facethesouth/require/docs/pcb.md

# Overall

* 6-layer PCB
* mechanical via only. no microvia or buried/blind vias.
* minimal trace width 0.1mm (4 mil)
* minimal via size 0.4mm/0.2mm (16mil/8mil)
* minimal soldermask width 0.1mm (4 mil)

# Footprint

The following footprint are created by the project. They should be carefully checked.

# Stack-up and Plane

- 2oz copper fill for top and bottom layer,  70μm or 2.8mil in thickness
- 1oz copper fill for inner layer, 35μm or 1.4 mil in thickness

|#|name|function|thickness(mil)|Material|
|-|-|-|-|-|
|1|top||2.8|copper|
||||3.6|FR4|
|2|in1|ground plane|1.4|copper|
||||4.6|FR4|
|3|in2|signal|1.4|copper|
||||36|FR4|
|4|in3|signal|1.4|copper|
||||4.6|FR4|
|5|in3|power plane|1.4|copper|
||||3.6|FR4|
|6|bottom||2.8|copper|

total thickness: 1.62mm (63.6mil)

# Copper Zone

TBD zone parameters

# Trace Width and Spacing

# Differential Pair

+ DDR
+ USB

# Testability

???
