facethesouth/require/hardware/Pinout.ods

Number | Pin | SPI | I2C | UART | PWM | GPIO
1 | W12 |  | SDA3 | RX3 |  | GPIO3_B4
2 | T12 |  | SCL3 | TX3 |  | GPIO3_B5
3 | U14 | MI0 |  | RX0 |  | GPIO2_A0
4 | V16 | MO0 |  | TX0 |  | GPIO2_A1
5 | Y16 | CK0 | SDA2 | CTS0 |  | GPIO2_A2
6 | W16 | CS0 | SCL2 | RTS0 |  | GPIO2_A3
7 | W9 | MI2 |  | CTS1/RX2 |  | GPIO1_C6 | TCK
8 | T9 | MO2 |  | RTS1/TX2 |  | GPIO1_C7 | TMS
9 | V10 | CK2 | SDA0 | RX1 |  | GPIO1_D0
10 | T10 | CS2 | SCL0 | TX1 |  | GPIO1_D1
11 | W2 |  |  |  | PWM1 | GPIO0_B6
12 | W1 |  | SDA3 |  | PWM2 | GPIO0_B7
13 | U2 |  | SCL3 |  | PWM3 | GPIO0_C0
19 | B15 |  |  | RX2 |  | GPIO4_D2
20 | A15 |  |  | TX2 |  | GPIO4_D3
