facethesouth/require/hardware/trace.ods

Sheet: Sheet1
 |  |  | layer | delta | total | 1.000 | 0
lock | BAS0 | 19.654 | 1 | 0 | 19.654
lock | BAS1 | 19.179 | 3 | 0.47752 | 19.657 | 3.000 | 0.47752 | l1-l6 | 57.2 | 2.90576
lock | BAS2 | 16.744 | 6 | 2.90576 | 19.650 | 4.000 | 2.36728 | l1-l4 | 46.6 | 2.36728 | 1 | 2.4 | 1
lock | A0 | 19.648 | 1 | 0 | 19.648 |  |  | l1-l3 | 9.4 | 0.47752 |  | 3.6
lock | A1 | 17.263 | 4 | 2.36728 | 19.630 | 6.000 | 2.90576 |  |  |  | 2 | 1.2
lock | A2 | 16.732 | 6 | 2.90576 | 19.638 |  |  |  |  |  |  | 4.6
lock | A3 | 16.756 | 6 | 2.90576 | 19.662 |  |  |  |  |  | 3 | 1.2
lock | A4 | 19.148 | 3 | 0.47752 | 19.626 |  |  |  |  |  |  | 36
lock | A5 | 19.647 | 1 | 0 | 19.647 |  |  |  |  |  | 4 | 1.2
lock | A6 | 19.182 | 3 | 0.47752 | 19.660 |  |  |  |  |  |  | 4.6
lock | A7 | 16.750 | 6 | 2.90576 | 19.656 |  |  |  |  |  | 5 | 1.2
lock | A8 | 19.633 | 1 | 0 | 19.633 |  |  |  |  |  |  | 3.6
lock | A9 | 16.727 | 6 | 2.90576 | 19.633 |  | 19.62-19.67 |  |  |  | 6 | 2.4
lock | A10 | 19.170 | 3 | 0.47752 | 19.648
lock | A11 | 17.281 | 4 | 2.36728 | 19.648
lock | A12 | 17.275 | 4 | 2.36728 | 19.642
lock | A13 | 19.161 | 3 | 0.47752 | 19.639
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
