facethesouth/require/hardware/RK3308_AI-VA_MB_REF_V12_20180914_05.png

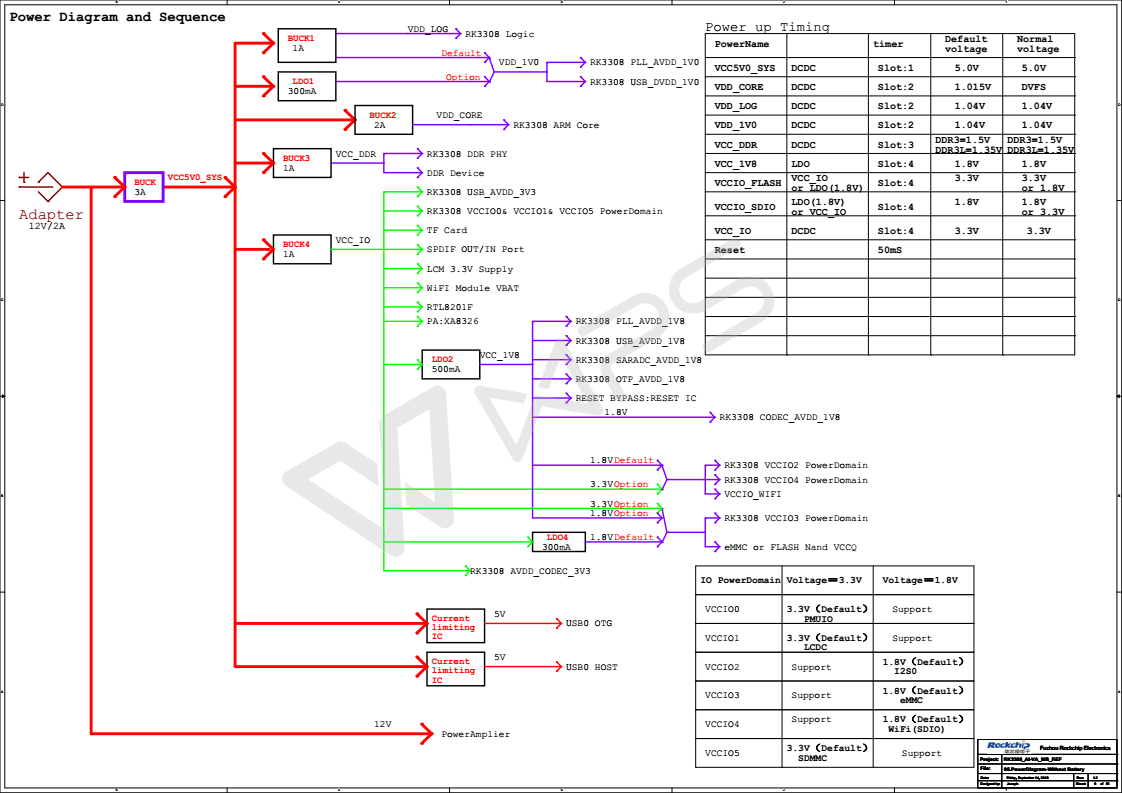
hardware/RK3308_AI-VA_MB_REF_V12_20180914_05.png
