facethesouth/require/hardware/BOM.ods

Ref | Qnty | Value | Part | Footprint | Description | Vendor
ANT1 | 1 | ANT_LA52H2450_5500_A28 | require:ANT_LA52H2450_5500_A28 | require:LA52H2450_5500_A28
C100, C101 | 2 | 22p | Device:C | require:C_0402 | Unpolarized capacitor
C110, C200, C206, C207, C226, C229, C255, C257, C265, C269, C310, C311, C312, C313, C314, C315, C316, C317, C318, C319, C320, C321, C322, C323, C324, C325, C326, C330, C351, C352, C401, C402, C406, C411 | 34 | 0.1u | Device:C | require:C_0402 | Unpolarized capacitor
C201, C221, C231, C251, C253, C254 | 6 | 10u,10V | Device:C | require:C_0805 | Unpolarized capacitor
C202, C222, C232, C252, C340 | 5 | 100p | Device:C | require:C_0402 | Unpolarized capacitor
C203, C204, C205 | 3 | 22u | Device:C | require:C_0603 | Unpolarized capacitor
C208, C405 | 2 | 2.2u | Device:C | require:C_0402 | Unpolarized capacitor
C210 | 1 | 10n | Device:C | require:C_0402 | Unpolarized capacitor
C223, C225, C233, C300, C301, C302, C350, C400, C410, C510, C511, C540 | 12 | 10u | Device:C | require:C_0603 | Unpolarized capacitor
C256, C258 | 2 | 0.47u | Device:C | require:C_0402 | Unpolarized capacitor
C260, C261, C420, C530, C830 | 5 | 1u | Device:C | require:C_0402 | Unpolarized capacitor
C331, C332 | 2 | 1n | Device:C | require:C_0402 | Unpolarized capacitor
C500, C501 | 2 | C | Device:C | require:C_0402 | Unpolarized capacitor
C520, C521 | 2 | 15p | Device:C | require:C_0402 | Unpolarized capacitor
D800, D810, D820 | 3 | PESDUC3FD5VU | require:PESDUC3FD5VU | require:SOT-883
F229, F269 | 2 | 180R,1.5A | Device:Ferrite_Bead | require:L_0402 | Ferrite bead
J800, J801 | 2 | Molex 105164-0001 | Connector:USB_B_Micro | require:USB_Micro-B_Molex-105164-0001 | USB Micro Type B connector
L200, L250, L540 | 3 | 2.2u | Device:L | require:L_1008 | Inductor
L220, L230 | 2 | 2.2u | Device:L | require:L_0806 | Inductor
L500 | 1 | L | Device:L | require:L_0402 | Inductor
R50 | 1 | 240R, 1% | Device:R | require:R_0402 | Resistor
R100, R400, R800, R801, R810, R811, R812, R813, R820, R821 | 10 | 22R | Device:R | require:R_0402 | Resistor
R110, R840, R841 | 3 | 10k | Device:R | require:R_0402 | Resistor
R202, R233 | 2 | 100k,1% | Device:R | require:R_0402 | Resistor
R203, R223, R232 | 3 | 150k,1% | Device:R | require:R_0402 | Resistor
R210 | 1 | 169k,1% | Device:R | require:R_0402 | Resistor
R211 | 1 | 10k,1% | Device:R | require:R_0402 | Resistor
R212 | 1 | 27k,1% | Device:R | require:R_0402 | Resistor
R213 | 1 | 12k,1% | Device:R | require:R_0402 | Resistor
R222 | 1 | 110k,1% | Device:R | require:R_0402 | Resistor
R252 | 1 | 540k,1% | Device:R | require:R_0402 | Resistor
R253 | 1 | 120k,1% | Device:R | require:R_0402 | Resistor
R330, R331 | 2 | 1k,1% | Device:R | require:R_0402 | Resistor
R340, R341 | 2 | 49.9R,1% | Device:R | require:R_0402 | Resistor
R410 | 1 | 2.2k | Device:R | require:R_0402 | Resistor
R700, R701 | 2 | 51k,1% | Device:R | require:R_0402 | Resistor
R805 | 1 | 133R,1% | Device:R | require:R_0402 | Resistor
R830, R831 | 2 | 4.7k | Device:R | require:R_0402 | Resistor
U100 | 1 | RK3308 | require:RK3308 | require:RK3308_TFBGA-355
U200, U250 | 2 | SY8089AAC | require:SY8089AAC | require:SOT-23-5 | 1A DC-DC Step Down
U220, U230 | 2 | PAM2305CGFADJ | Regulator_Switching:PAM2305CGFADJ | require:U-DFN2020-6 | 1A, Step-Down DC/DC-Converter, Adjustable Output Voltage, 1.5MHz, DFN-6
U260 | 1 | NCP707CMX180TCG | require:NCP707_XDFN4 | require:XDFN4
U300 | 1 | DDR3_FBGA96 | require:DDR3_FBGA96 | require:DDR3_BGA-96
U400 | 1 | EMMC_BGA_153 | require:EMMC_BGA_153 | require:BGA-153_14x14_11.5x13.0mm
U500 | 1 | ap6255 | require:AP6255 | require:AP6255_QFP_44
U830 | 1 | ATECC608A-MAHDA | Security:ATECC608A-MAHDA | require:ATECC_UDFN8 | Cryptographic Co-Processor with Secure Hardware-based 16 Key Storage, ECDSA and ECDH support, I2C, UDFN-8
Y100 | 1 | 24MHz,12pF,10ppm | Device:Crystal_GND24 | require:Crystal_SMD_2016-4pin_2.0x1.6mm | Four pin crystal, GND on pins 2 and 4
Y520 | 1 | 37.4MHz,9pF,10ppm | Device:Crystal_GND24 | require:Crystal_SMD_2016-4pin_2.0x1.6mm | Four pin crystal, GND on pins 2 and 4
