facethesouth/require/hardware/3d/USB-AM-S-F-B-SM1.stp

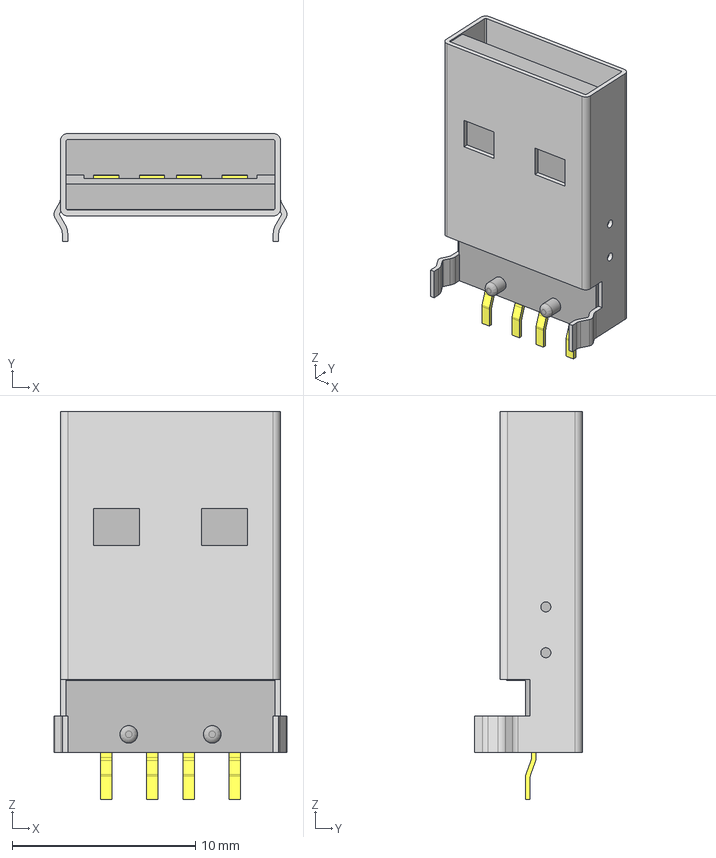
[picture p2: CAD file, 2019-05-17]
hardware/3d/USB-AM-S-F-B-SM1.stp
12.7 x 5.89 x 21.1 mm
_USB-AM-S-SM1_S
_USB-AM-S-B-SM1_B
_USB-AM-S-SM1_P
