facethesouth/require/hardware/3d/stack.step

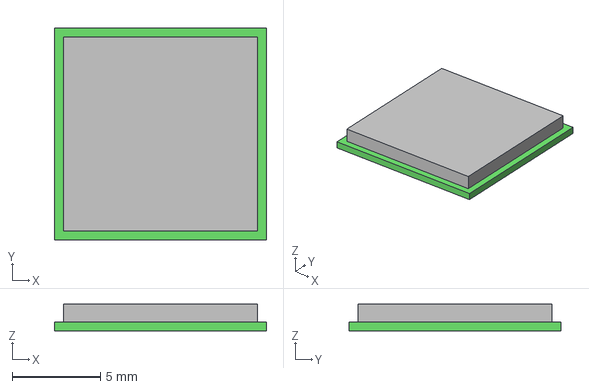
[picture p3: CAD file, 2019-05-15]
hardware/3d/stack.step
12.0 x 12.0 x 1.50 mm
