facethesouth/require/hardware/3d/Crystal_SMD_2016.STEP

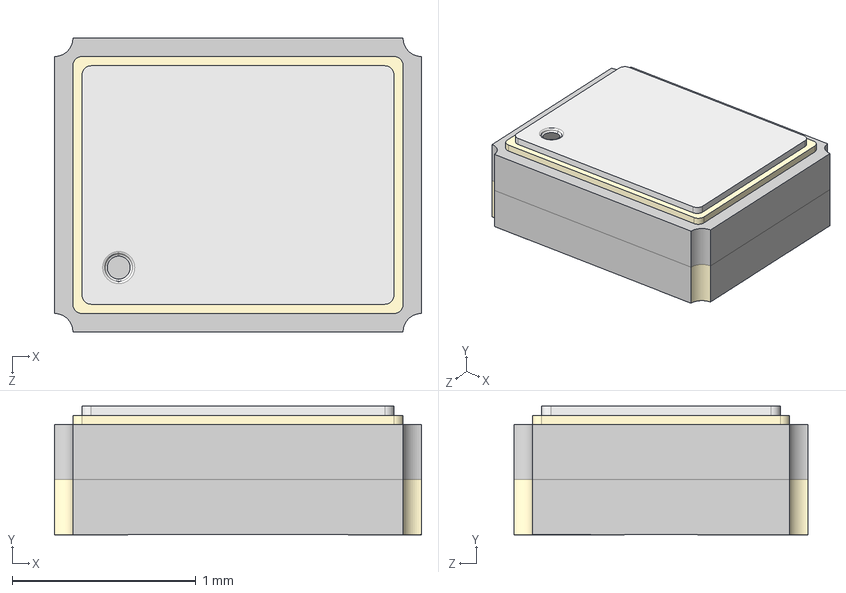
[picture p4: CAD file, 2019-05-15]
hardware/3d/Crystal_SMD_2016.STEP
2.00 x 0.701 x 1.60 mm
