facethesouth/require/hardware/3d/LA52H.step

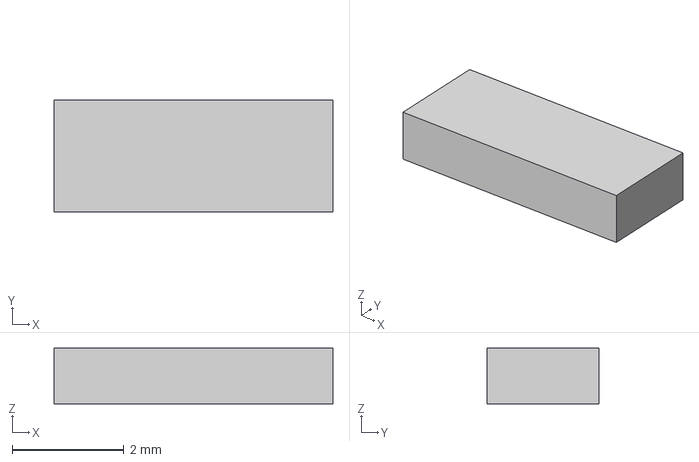
[picture p5: CAD file, 2019-05-15]
hardware/3d/LA52H.step
5.00 x 2.00 x 1.00 mm
