facethesouth/require/hardware/3d/User Library-HL6528.STEP

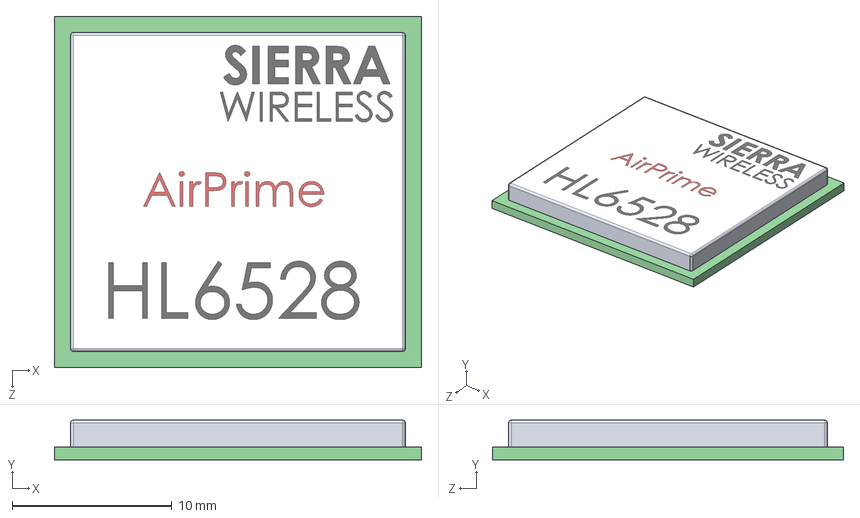
[picture p6: CAD file, 2019-05-15]
hardware/3d/User Library-HL6528.STEP
23.0 x 2.50 x 22.0 mm
