facethesouth/require/hardware/3d/BLM15PX181SN1D.stp

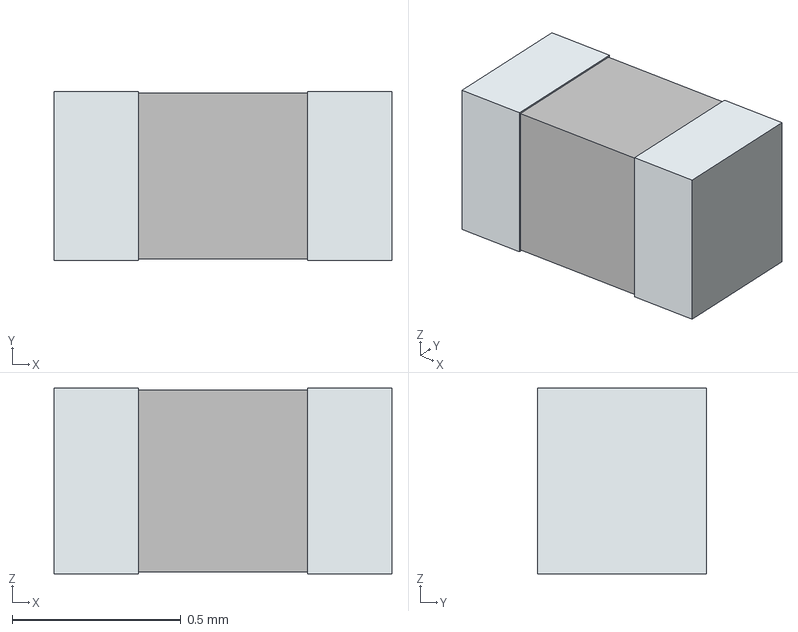
[picture p7: CAD file, 2019-03-10]
hardware/3d/BLM15PX181SN1D.stp
1.00 x 0.5 x 0.55 mm
term1
term2
