facethesouth/require/hardware/3d/X1-DFN1006-3.stp

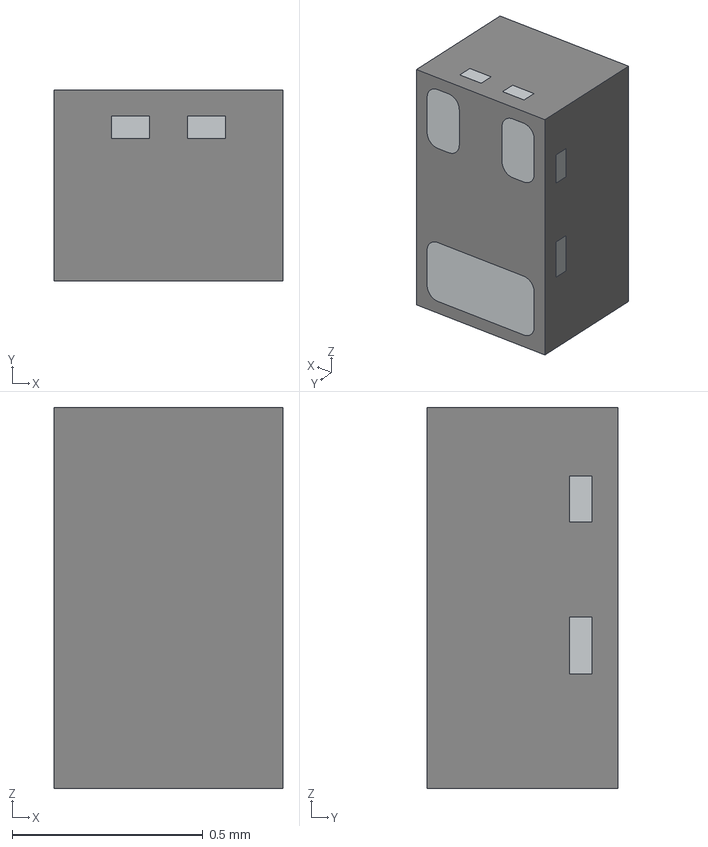
[picture p8: CAD file, 2019-03-05]
hardware/3d/X1-DFN1006-3.stp
0.6 x 0.5 x 1.00 mm
LF
