facethesouth/require/hardware/3d/ZX62R-B-5P.stp

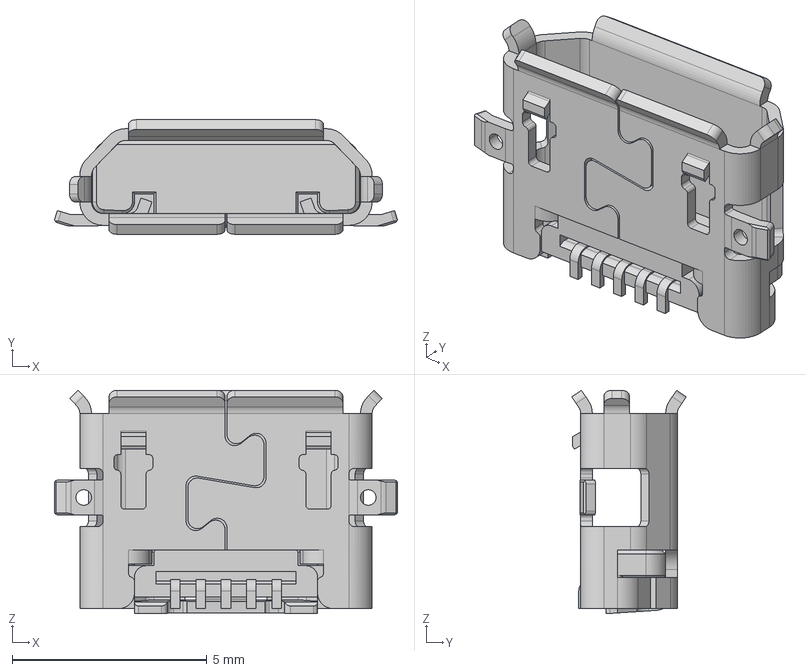
[picture p9: CAD file, 2019-03-04]
hardware/3d/ZX62R-B-5P.stp
8.80 x 2.94 x 5.73 mm
