facethesouth/require/hardware/3d/U-DFN2020-6.stp

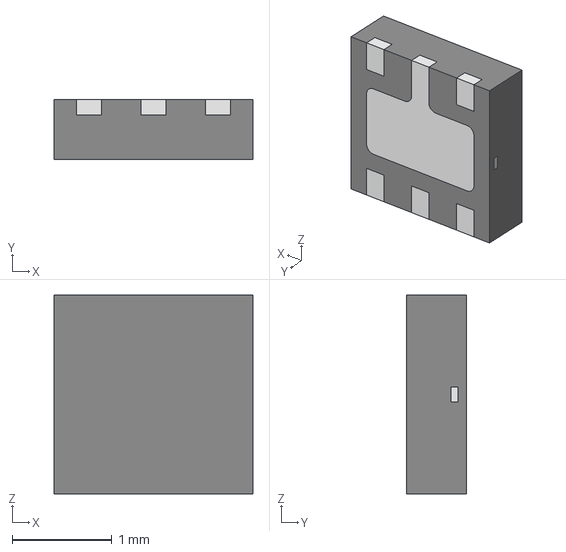
[picture p10: CAD file, 2019-03-04]
hardware/3d/U-DFN2020-6.stp
2.00 x 0.6 x 2.00 mm
SLP2020P6-LF
SOT23-QFN-Compound
