facethesouth/require/hardware/3d/LQM2MP_G0.stp

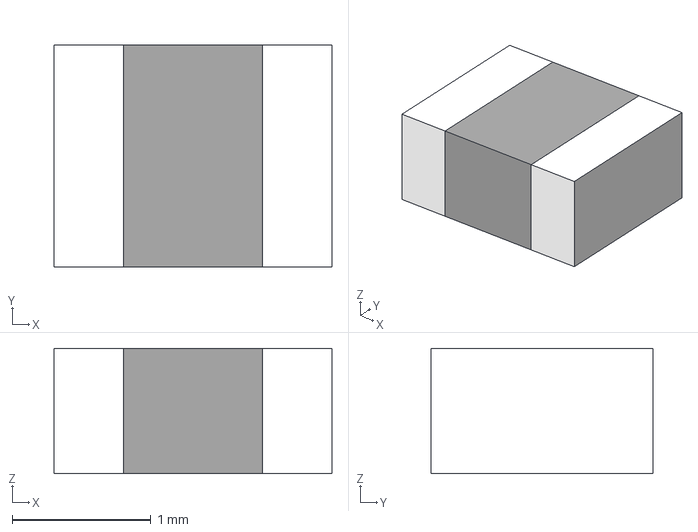
[picture p11: CAD file, 2019-02-28]
hardware/3d/LQM2MP_G0.stp
2.00 x 1.60 x 0.9 mm
