facethesouth/require/hardware/3d/USB-AM-S-F-B-TH.stp

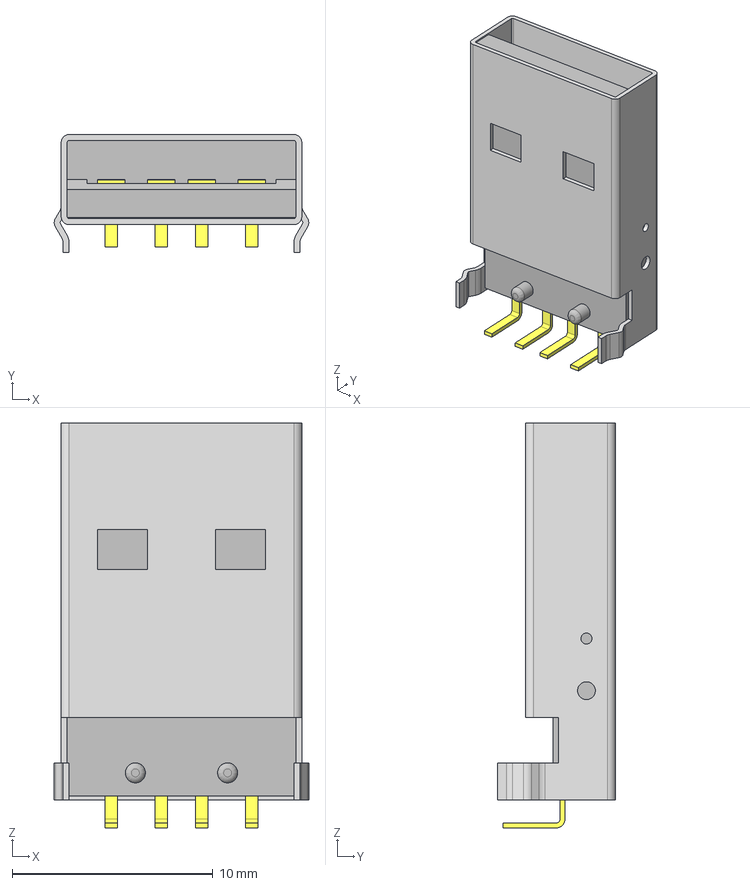
[picture p12: CAD file, 2019-02-20]
hardware/3d/USB-AM-S-F-B-TH.stp
12.7 x 5.89 x 20.2 mm
_USB-AM-S-TH_S
_USB-AM-S-B-TH_B
_USB-AM-S-TH_P
