facethesouth/require/hardware/3d/User Library-UDFN-8.STEP

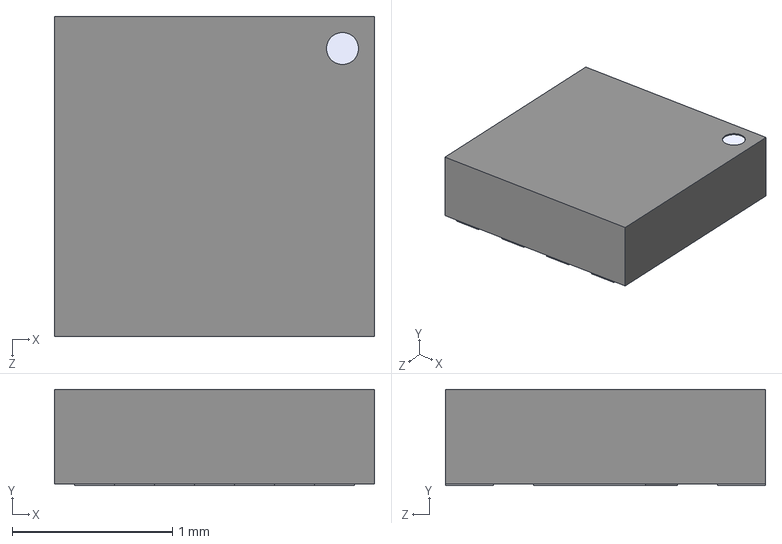
[picture p13: CAD file, 2019-02-20]
hardware/3d/User Library-UDFN-8.STEP
2.00 x 0.6 x 2.00 mm
