facethesouth/require/hardware/3d/SKSGAC.STEP

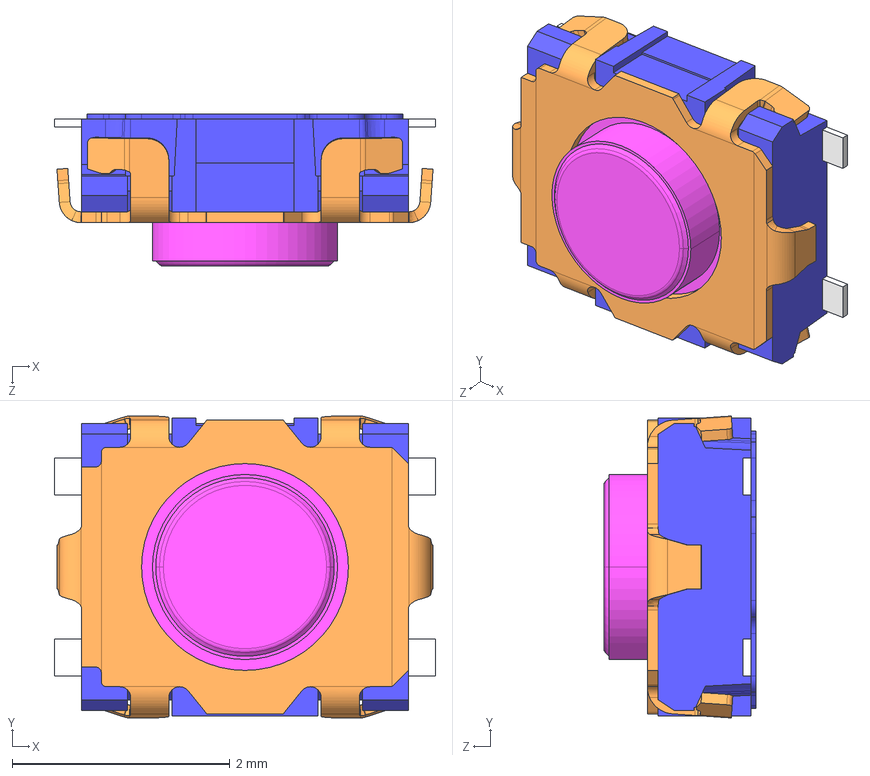
[picture p14: CAD file, 2019-02-20]
hardware/3d/SKSGAC.STEP
3.50 x 2.77 x 1.40 mm
