facethesouth/require/hardware/3d/SKSHAA.STEP

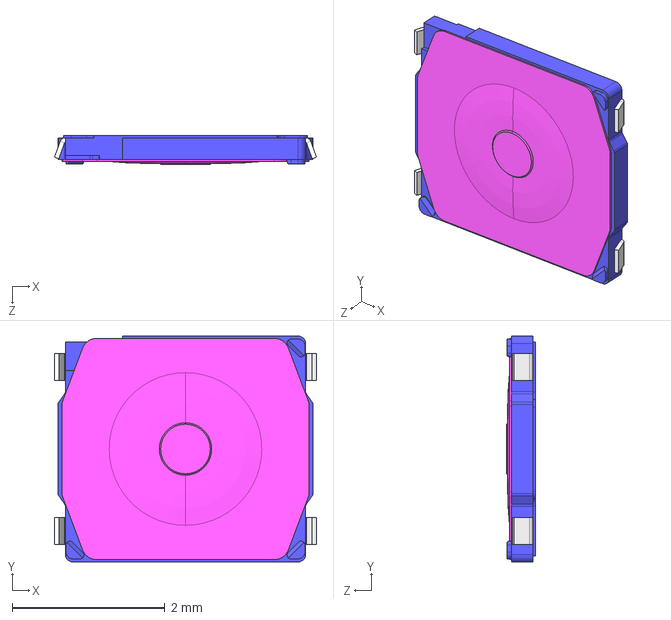
[picture p15: CAD file, 2019-02-20]
hardware/3d/SKSHAA.STEP
3.43 x 2.96 x 0.379 mm
