facethesouth/require/hardware/3d/LQM2HP_J0.stp

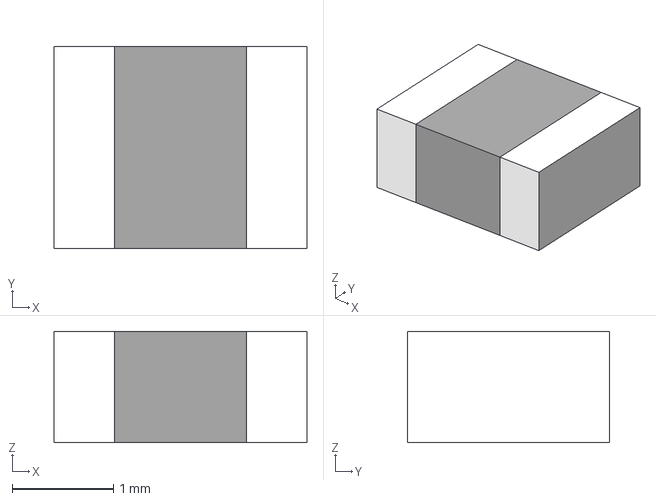
[picture p16: CAD file, 2019-02-12]
hardware/3d/LQM2HP_J0.stp
2.50 x 2.00 x 1.10 mm
