facethesouth/require/hardware/3d/SKSCLD.STEP

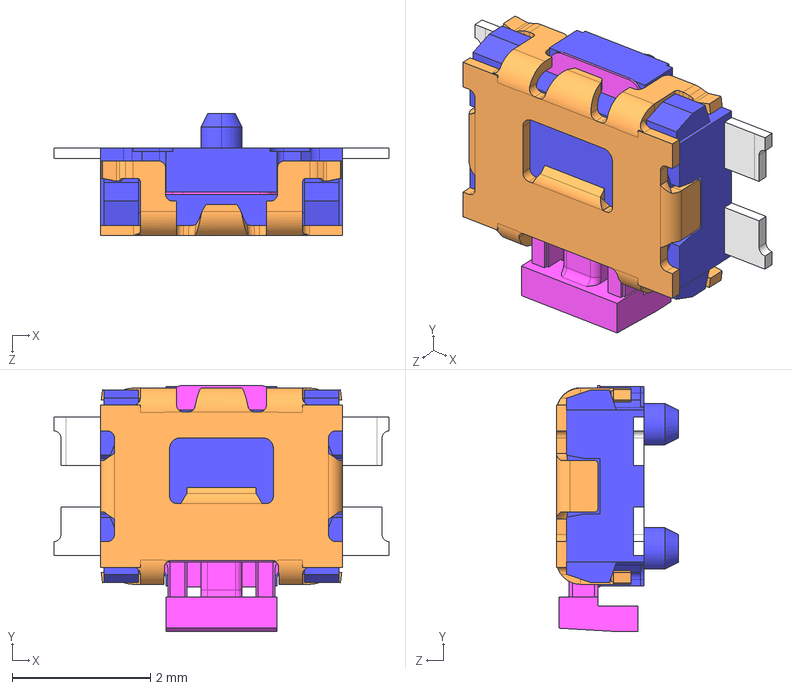
[picture p17: CAD file, 2019-01-24]
hardware/3d/SKSCLD.STEP
4.85 x 3.57 x 1.77 mm
