facethesouth/require/hardware/3d/SKSCLC.STEP

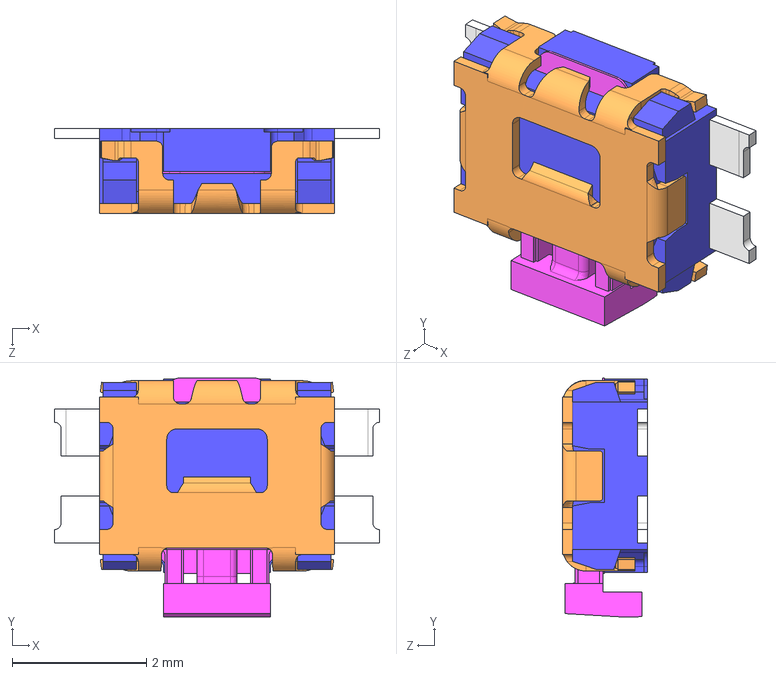
[picture p18: CAD file, 2019-01-23]
hardware/3d/SKSCLC.STEP
4.85 x 3.56 x 1.27 mm
