facethesouth/require/hardware/3d/User Library-96-FBGA (14X9).STEP

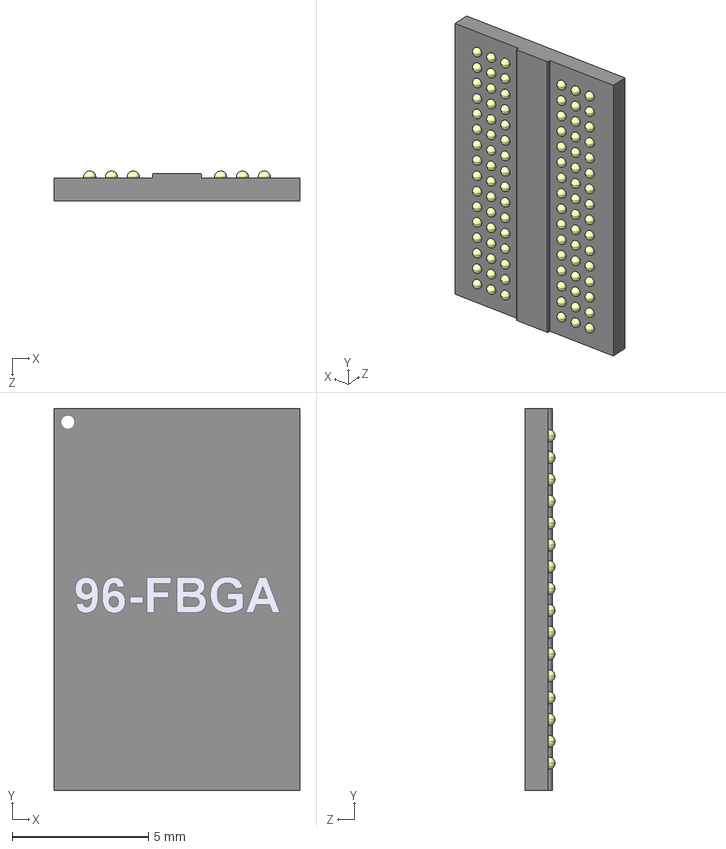
[picture p19: CAD file, 2019-01-23]
hardware/3d/User Library-96-FBGA (14X9).STEP
9.00 x 14.0 x 1.10 mm
