facethesouth/require/hardware/3d/User Library-MOB0063A.STEP

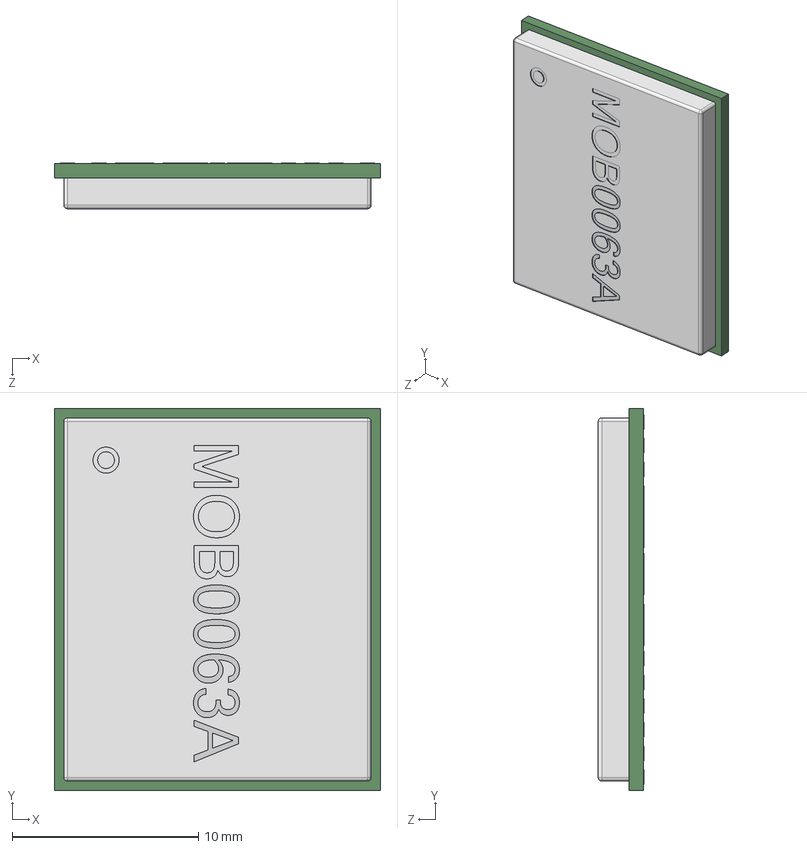
[picture p20: CAD file, 2019-01-23]
hardware/3d/User Library-MOB0063A.STEP
17.5 x 20.5 x 2.45 mm
User Library-MOB0063A_Imported
User Library-MOB0063A_Imported_2
User Library-MOB0063A_Imported_3
User Library-MOB0063A_Imported_4
