facethesouth/require/hardware/3d/User Library-153BallWFBGA.STEP

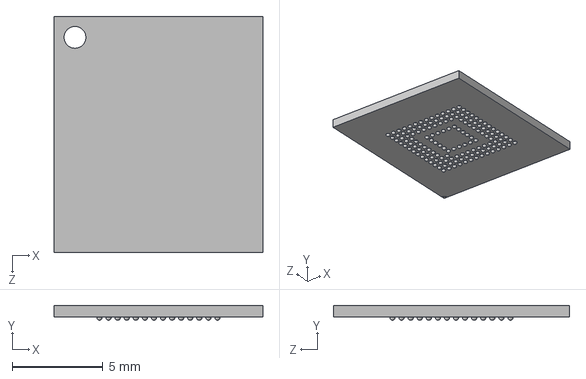
[picture p21: CAD file, 2019-01-23]
hardware/3d/User Library-153BallWFBGA.STEP
11.5 x 0.802 x 13.0 mm
