facethesouth/require/hardware/3d/User Library-EPSON_SG-3030CM.STEP

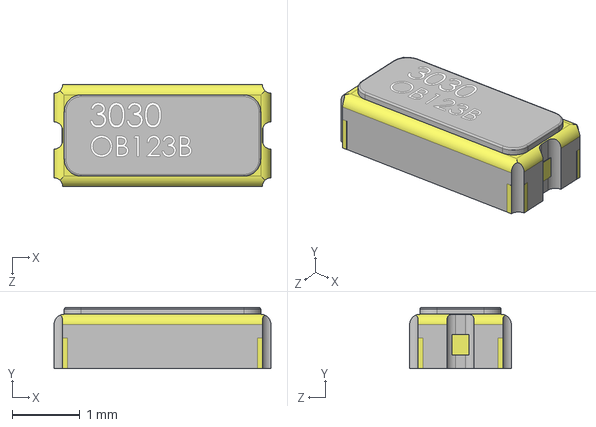
[picture p22: CAD file, 2019-01-23]
hardware/3d/User Library-EPSON_SG-3030CM.STEP
3.20 x 0.901 x 1.50 mm
