facethesouth/require/(list of files, cad)

Other CAD files:
hardware/3d/AP6255.step
hardware/3d/10118194c.stp
hardware/3d/1050170001.stp
hardware/3d/1051640001.stp
hardware/3d/BLM15PX181SN1D.stl
hardware/3d/ap6255.FCStd
hardware/3d/la52h.FCStd
