facethesouth/require/hardware/require.kicad_pcb

## KiCad design hardware/require.kicad_pcb (2019-05-17)

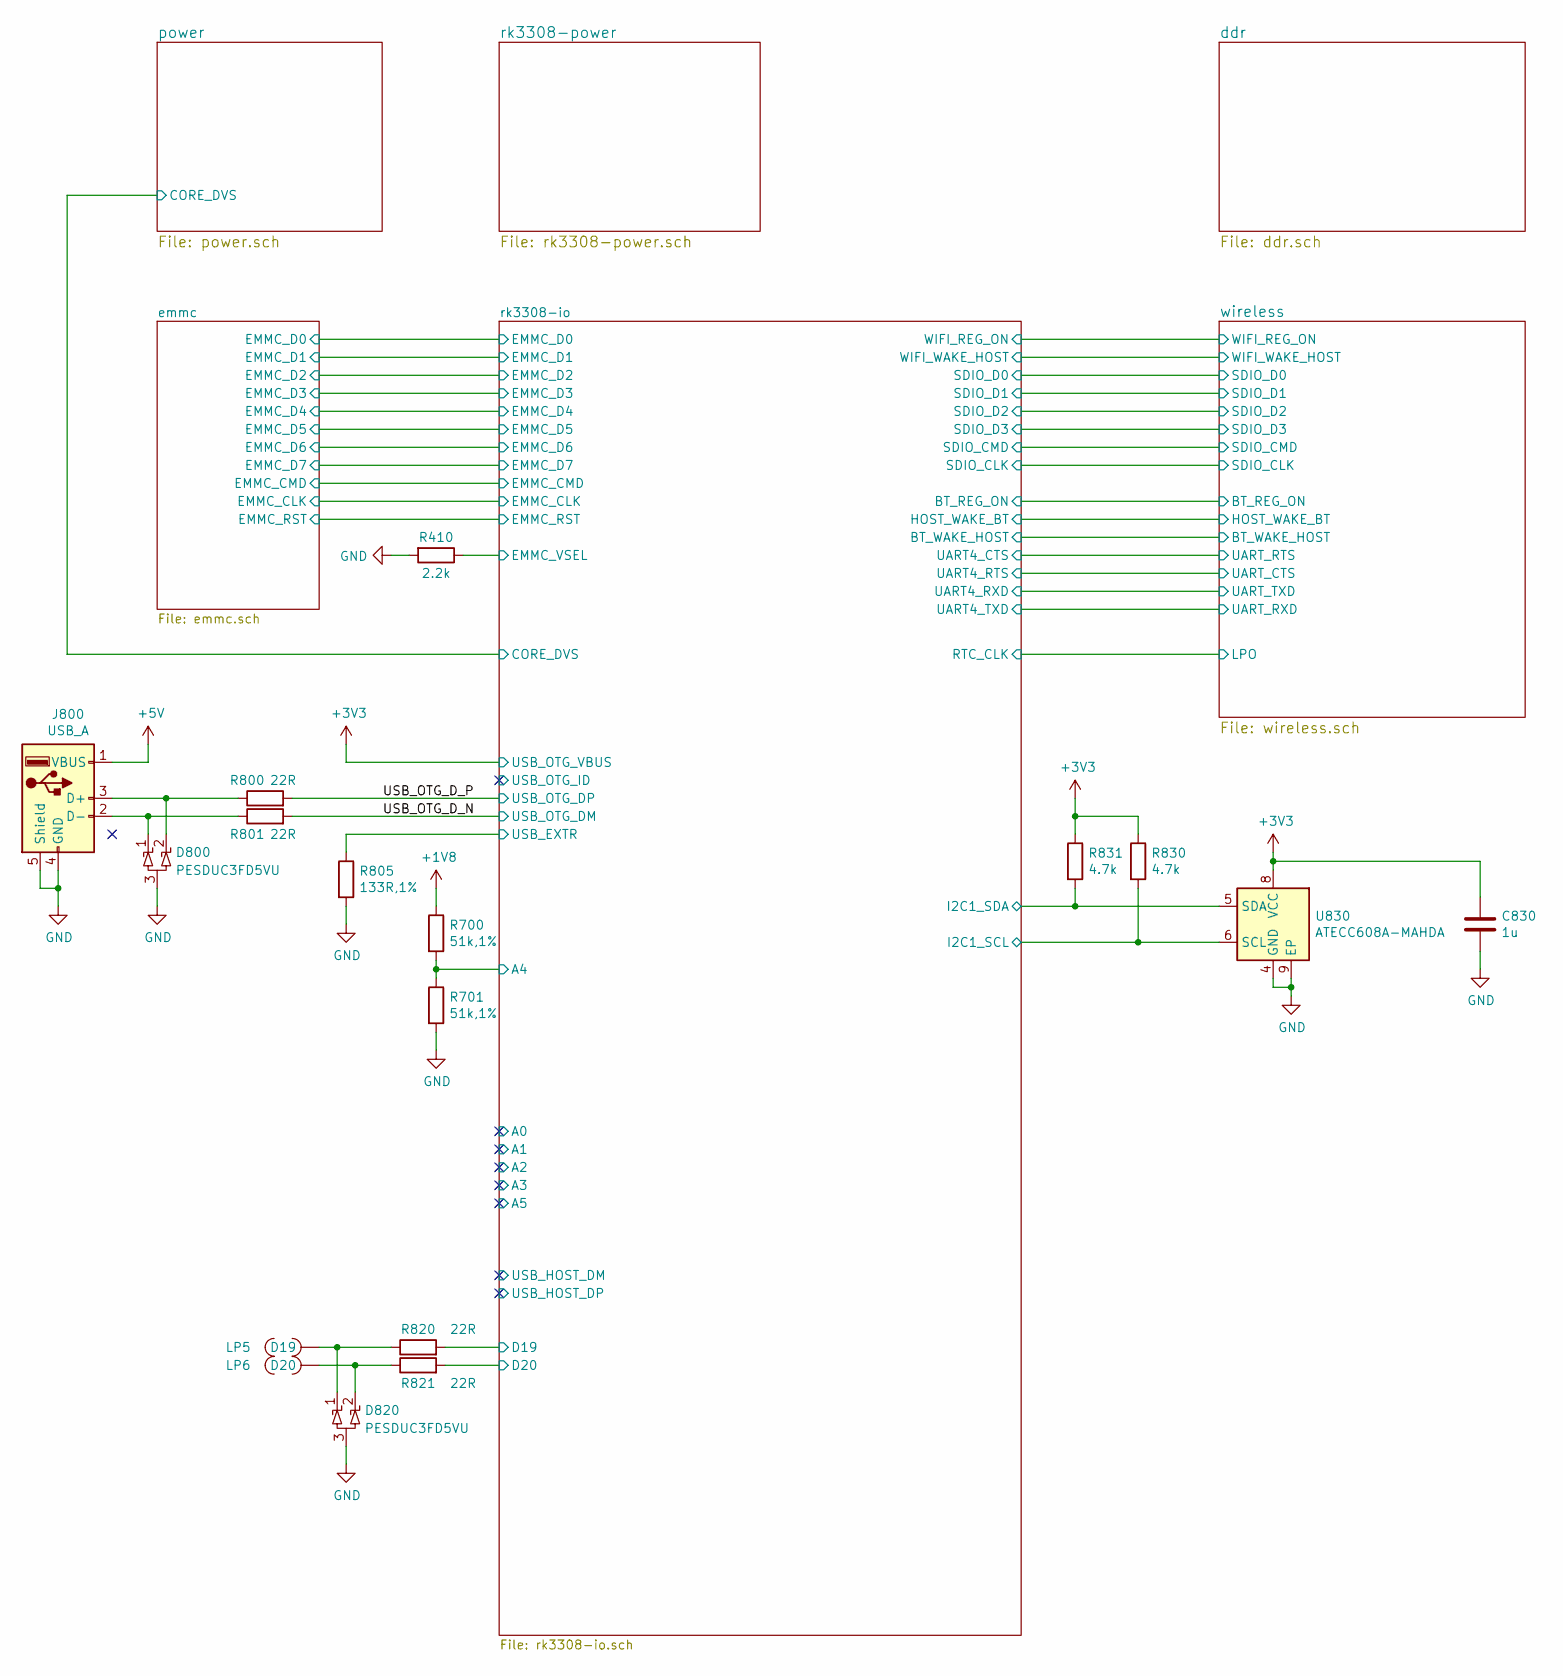
[picture p24: schematic require.sch]

Parts:
C830: 1u; C_0402
D800, D820: PESDUC3FD5VU; SOT-883
J800: USB_A; USB-AM-S-F-B-TH
LP5: D19; OVAL_PIN
LP6: D20; OVAL_PIN
R410: 2.2k; R_0402
R700, R701: 51k,1%; R_0402
R800, R801, R820, R821: 22R; R_0402
R805: 133R,1%; R_0402
R830, R831: 4.7k; R_0402
U830: ATECC608A-MAHDA; ATECC_UDFN8

Connections:
+1V8: R700.1; also elsewhere on the board
+3V3: C830.1, R830.1, R831.1, U830.8 (VCC); also elsewhere on the board
+5V: J800.1 (VBUS); also elsewhere on the board
/USB_OTG_D_N: R801.2; also elsewhere on the board
/USB_OTG_D_P: R800.2; also elsewhere on the board
/rk3308-io/A4: R700.2, R701.1; also elsewhere on the board
/rk3308-io/D19: R820.2; also elsewhere on the board
/rk3308-io/D20: R821.2; also elsewhere on the board
/rk3308-io/EMMC_VSEL: R410.1; also elsewhere on the board
/rk3308-io/I2C1_SCL: R830.2, U830.6 (SCL); also elsewhere on the board
/rk3308-io/I2C1_SDA: R831.2, U830.5 (SDA); also elsewhere on the board
/rk3308-io/USB_EXTR: R805.1; also elsewhere on the board
GND: C830.2, D800.3, D820.3, J800.4 (GND), J800.5 (Shield), R410.2, R701.2, R805.2, U830.4 (GND), U830.9 (EP); also elsewhere on the board
unnamed: D800.1, J800.2 (D-), R801.1
unnamed: D800.2, J800.3 (D+), R800.1
unnamed: D820.1, LP5.1, R820.1
unnamed: D820.2, LP6.1, R821.1

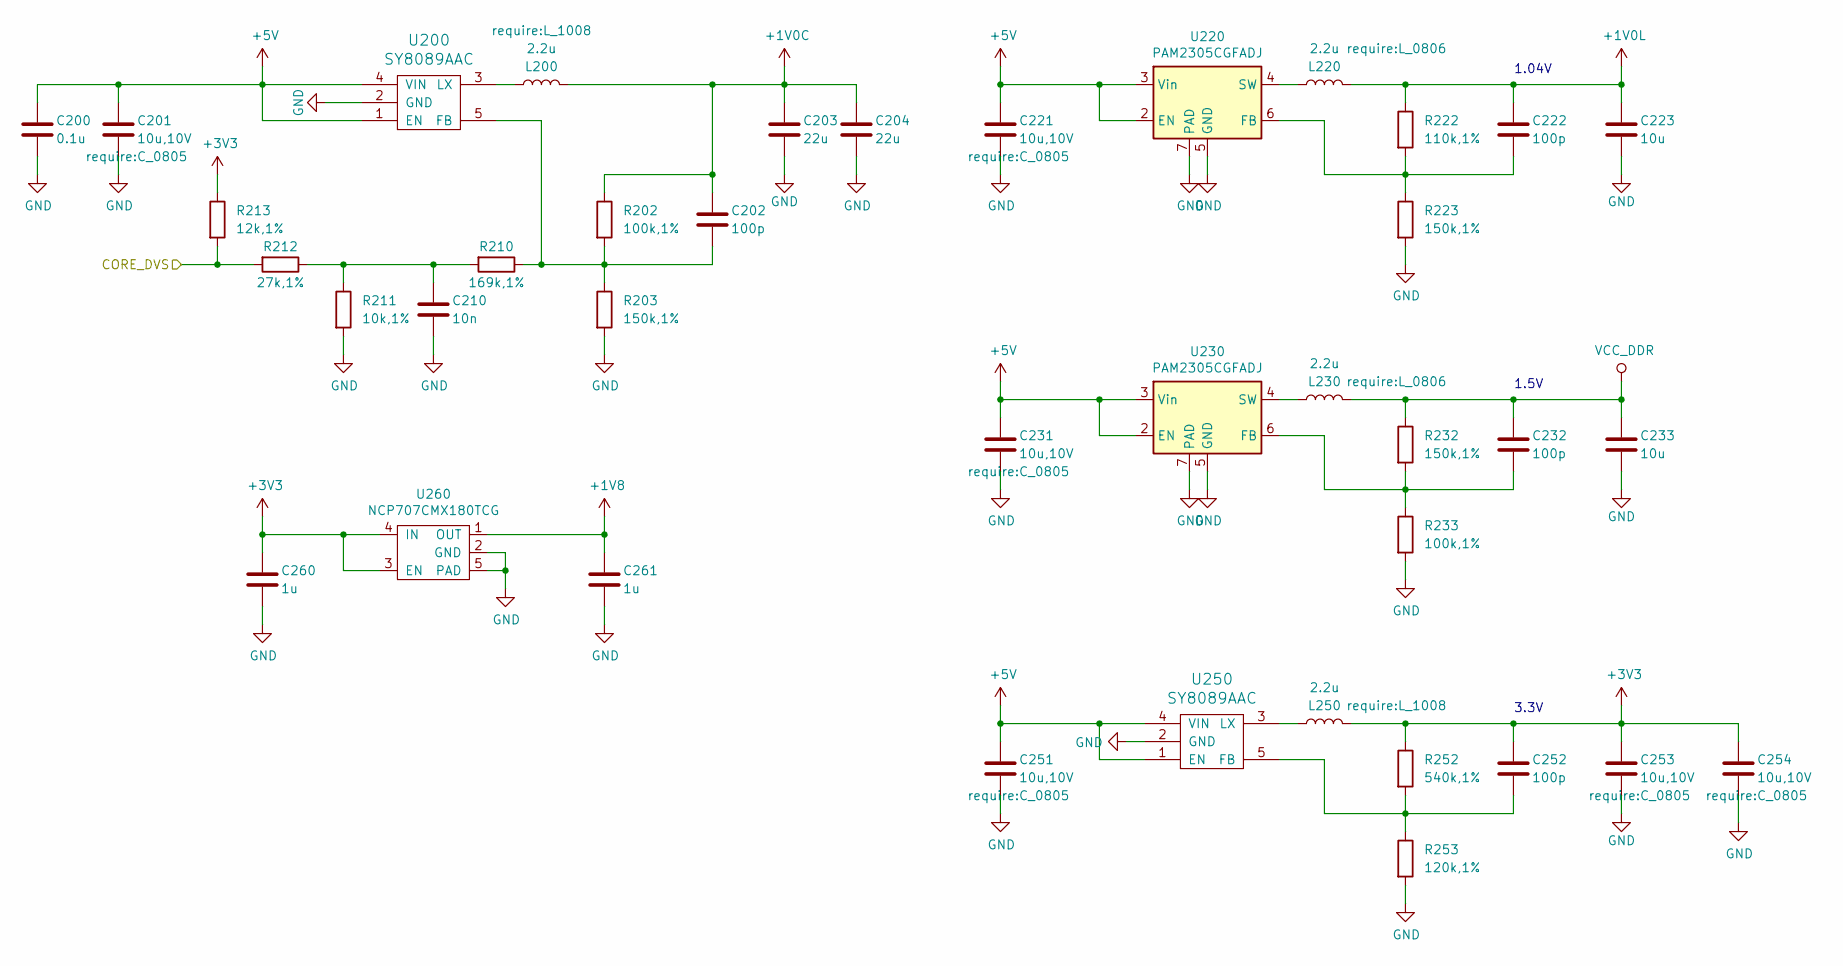
[picture p25: schematic power.sch]

Parts:
C200: 0.1u; C_0402
C201, C221, C231, C251, C253, C254: 10u,10V; C_0805; Voltage 10V
C202, C222, C232, C252: 100p; C_0402
C203, C204: 22u; C_0603
C210: 10n; C_0402
C223, C233: 10u; C_0603
C260, C261: 1u; C_0402
L200, L250: 2.2u; L_1008
L220, L230: 2.2u; L_0806
R202, R233: 100k,1%; R_0402
R203, R223, R232: 150k,1%; R_0402
R210: 169k,1%; R_0402
R211: 10k,1%; R_0402
R212: 27k,1%; R_0402
R213: 12k,1%; R_0402
R222: 110k,1%; R_0402
R252: 540k,1%; R_0402
R253: 120k,1%; R_0402
U200, U250: SY8089AAC; SOT-23-5
U220, U230: PAM2305CGFADJ; U-DFN2020-6
U260: NCP707CMX180TCG; XDFN4

Connections:
+1V0C: C202.1, C203.1, C204.1, L200.2, R202.1; also elsewhere on the board
+1V0L: C222.1, C223.1, L220.2, R222.1; also elsewhere on the board
+1V8: C261.1, U260.1 (OUT); also elsewhere on the board
+3V3: C252.1, C253.1, C254.1, C260.1, L250.2, R213.1, R252.1, U260.3 (EN), U260.4 (IN); also elsewhere on the board
+5V: C200.1, C201.1, C221.1, C231.1, C251.1, U200.1 (EN), U200.4 (VIN), U220.2 (EN), U220.3 (Vin), U230.2 (EN), U230.3 (Vin), U250.1 (EN), U250.4 (VIN); also elsewhere on the board
/power/CORE_DVS: R212.2, R213.2; also elsewhere on the board
GND: C200.2, C201.2, C203.2, C204.2, C210.2, C221.2, C223.2, C231.2, C233.2, C251.2, C253.2, C254.2, C260.2, C261.2, R203.2, R211.2, R223.2, R233.2, R253.2, U200.2 (GND), U220.5 (GND), U220.7 (PAD), U230.5 (GND), U230.7 (PAD), U250.2 (GND), U260.2 (GND), U260.5 (PAD); also elsewhere on the board
unnamed: C202.2, R202.2, R203.1, R210.1, U200.5 (FB)
unnamed: C210.1, R210.2, R211.1, R212.1
unnamed: C222.2, R222.2, R223.1, U220.6 (FB)
unnamed: C232.2, R232.2, R233.1, U230.6 (FB)
unnamed: C252.2, R252.2, R253.1, U250.5 (FB)
unnamed: L200.1, U200.3 (LX)
unnamed: L220.1, U220.4 (SW)
unnamed: L230.1, U230.4 (SW)
unnamed: L250.1, U250.3 (LX)
VCC_DDR: C232.1, C233.1, L230.2, R232.1; also elsewhere on the board

Notes on the sheet:
1.04V
1.5V
3.3V

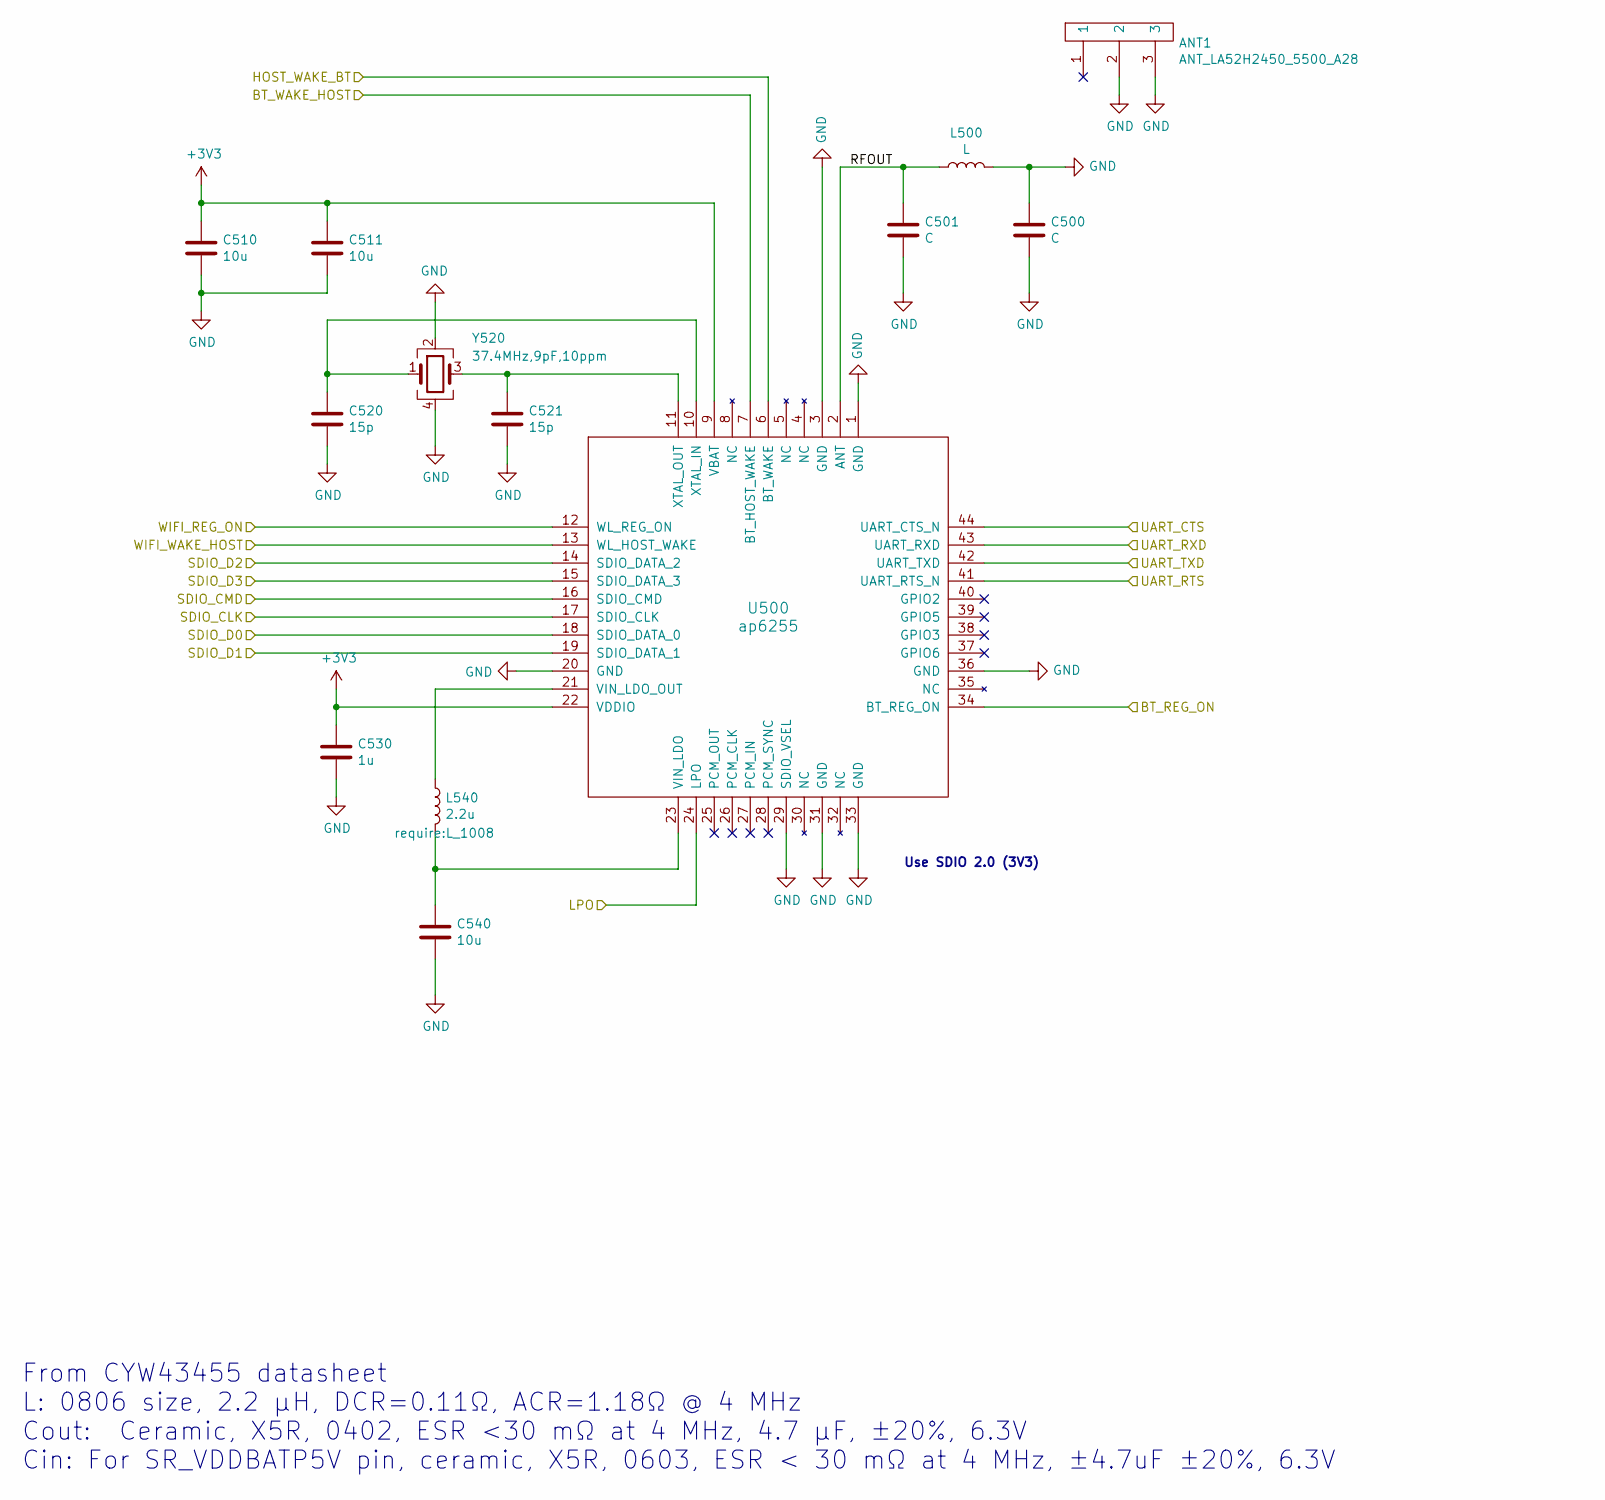
[picture p26: schematic wireless.sch]

Parts:
ANT1: ANT_LA52H2450_5500_A28; LA52H2450_5500_A28
C500, C501: C; C_0402
C510, C511, C540: 10u; C_0603
C520, C521: 15p; C_0402
C530: 1u; C_0402
L500: L; L_0402
L540: 2.2u; L_1008
U500: ap6255; AP6255_QFP_44
Y520: 37.4MHz,9pF,10ppm; Crystal_SMD_2016-4pin_2.0x1.6mm

Connections:
+3V3: C510.1, C511.1, C530.1, U500.9 (VBAT), U500.22 (VDDIO); also elsewhere on the board
/rk3308-io/BT_REG_ON: U500.34 (BT_REG_ON); also elsewhere on the board
/rk3308-io/BT_WAKE_HOST: U500.7 (BT_HOST_WAKE); also elsewhere on the board
/rk3308-io/HOST_WAKE_BT: U500.6 (BT_WAKE); also elsewhere on the board
/rk3308-io/SDIO_CLK: U500.17 (SDIO_CLK); also elsewhere on the board
/rk3308-io/SDIO_CMD: U500.16 (SDIO_CMD); also elsewhere on the board
/rk3308-io/SDIO_D0: U500.18 (SDIO_DATA_0); also elsewhere on the board
/rk3308-io/SDIO_D1: U500.19 (SDIO_DATA_1); also elsewhere on the board
/rk3308-io/SDIO_D2: U500.14 (SDIO_DATA_2); also elsewhere on the board
/rk3308-io/SDIO_D3: U500.15 (SDIO_DATA_3); also elsewhere on the board
/rk3308-io/UART4_CTS: U500.41 (UART_RTS_N); also elsewhere on the board
/rk3308-io/UART4_RTS: U500.44 (UART_CTS_N); also elsewhere on the board
/rk3308-io/UART4_RXD: U500.42 (UART_TXD); also elsewhere on the board
/rk3308-io/UART4_TXD: U500.43 (UART_RXD); also elsewhere on the board
/rk3308-io/WIFI_REG_ON: U500.12 (WL_REG_ON); also elsewhere on the board
/rk3308-io/WIFI_WAKE_HOST: U500.13 (WL_HOST_WAKE); also elsewhere on the board
/wireless/LPO: U500.24 (LPO); also elsewhere on the board
/wireless/RFOUT: C501.1, L500.1, U500.2 (ANT)
GND: ANT1.2, ANT1.3, C500.1, C500.2, C501.2, C510.2, C511.2, C520.2, C521.2, C530.2, C540.2, L500.2, U500.1 (GND), U500.3 (GND), U500.20 (GND), U500.29 (SDIO_VSEL), U500.31 (GND), U500.33 (GND), U500.36 (GND), Y520.2, Y520.4; also elsewhere on the board
unnamed: C520.1, U500.10 (XTAL_IN), Y520.1
unnamed: C521.1, U500.11 (XTAL_OUT), Y520.3
unnamed: C540.1, L540.2, U500.23 (VIN_LDO)
unnamed: L540.1, U500.21 (VIN_LDO_OUT)

Notes on the sheet:
Use SDIO 2.0 (3V3)
From CYW43455 datasheet L: 0806 size, 2.2 µH, DCR=0.11Ω, ACR=1.18Ω @ 4 MHz Cout: Ceramic, X5R, 0402, ESR <30 mΩ at 4 MHz, 4.7 µF, ±20%, 6.3V Cin: For SR_VDDBATP5V pin, ceramic, X5R, 0603, ESR < 30 mΩ at 4 MHz, ±4.7uF ±20%, 6.3V

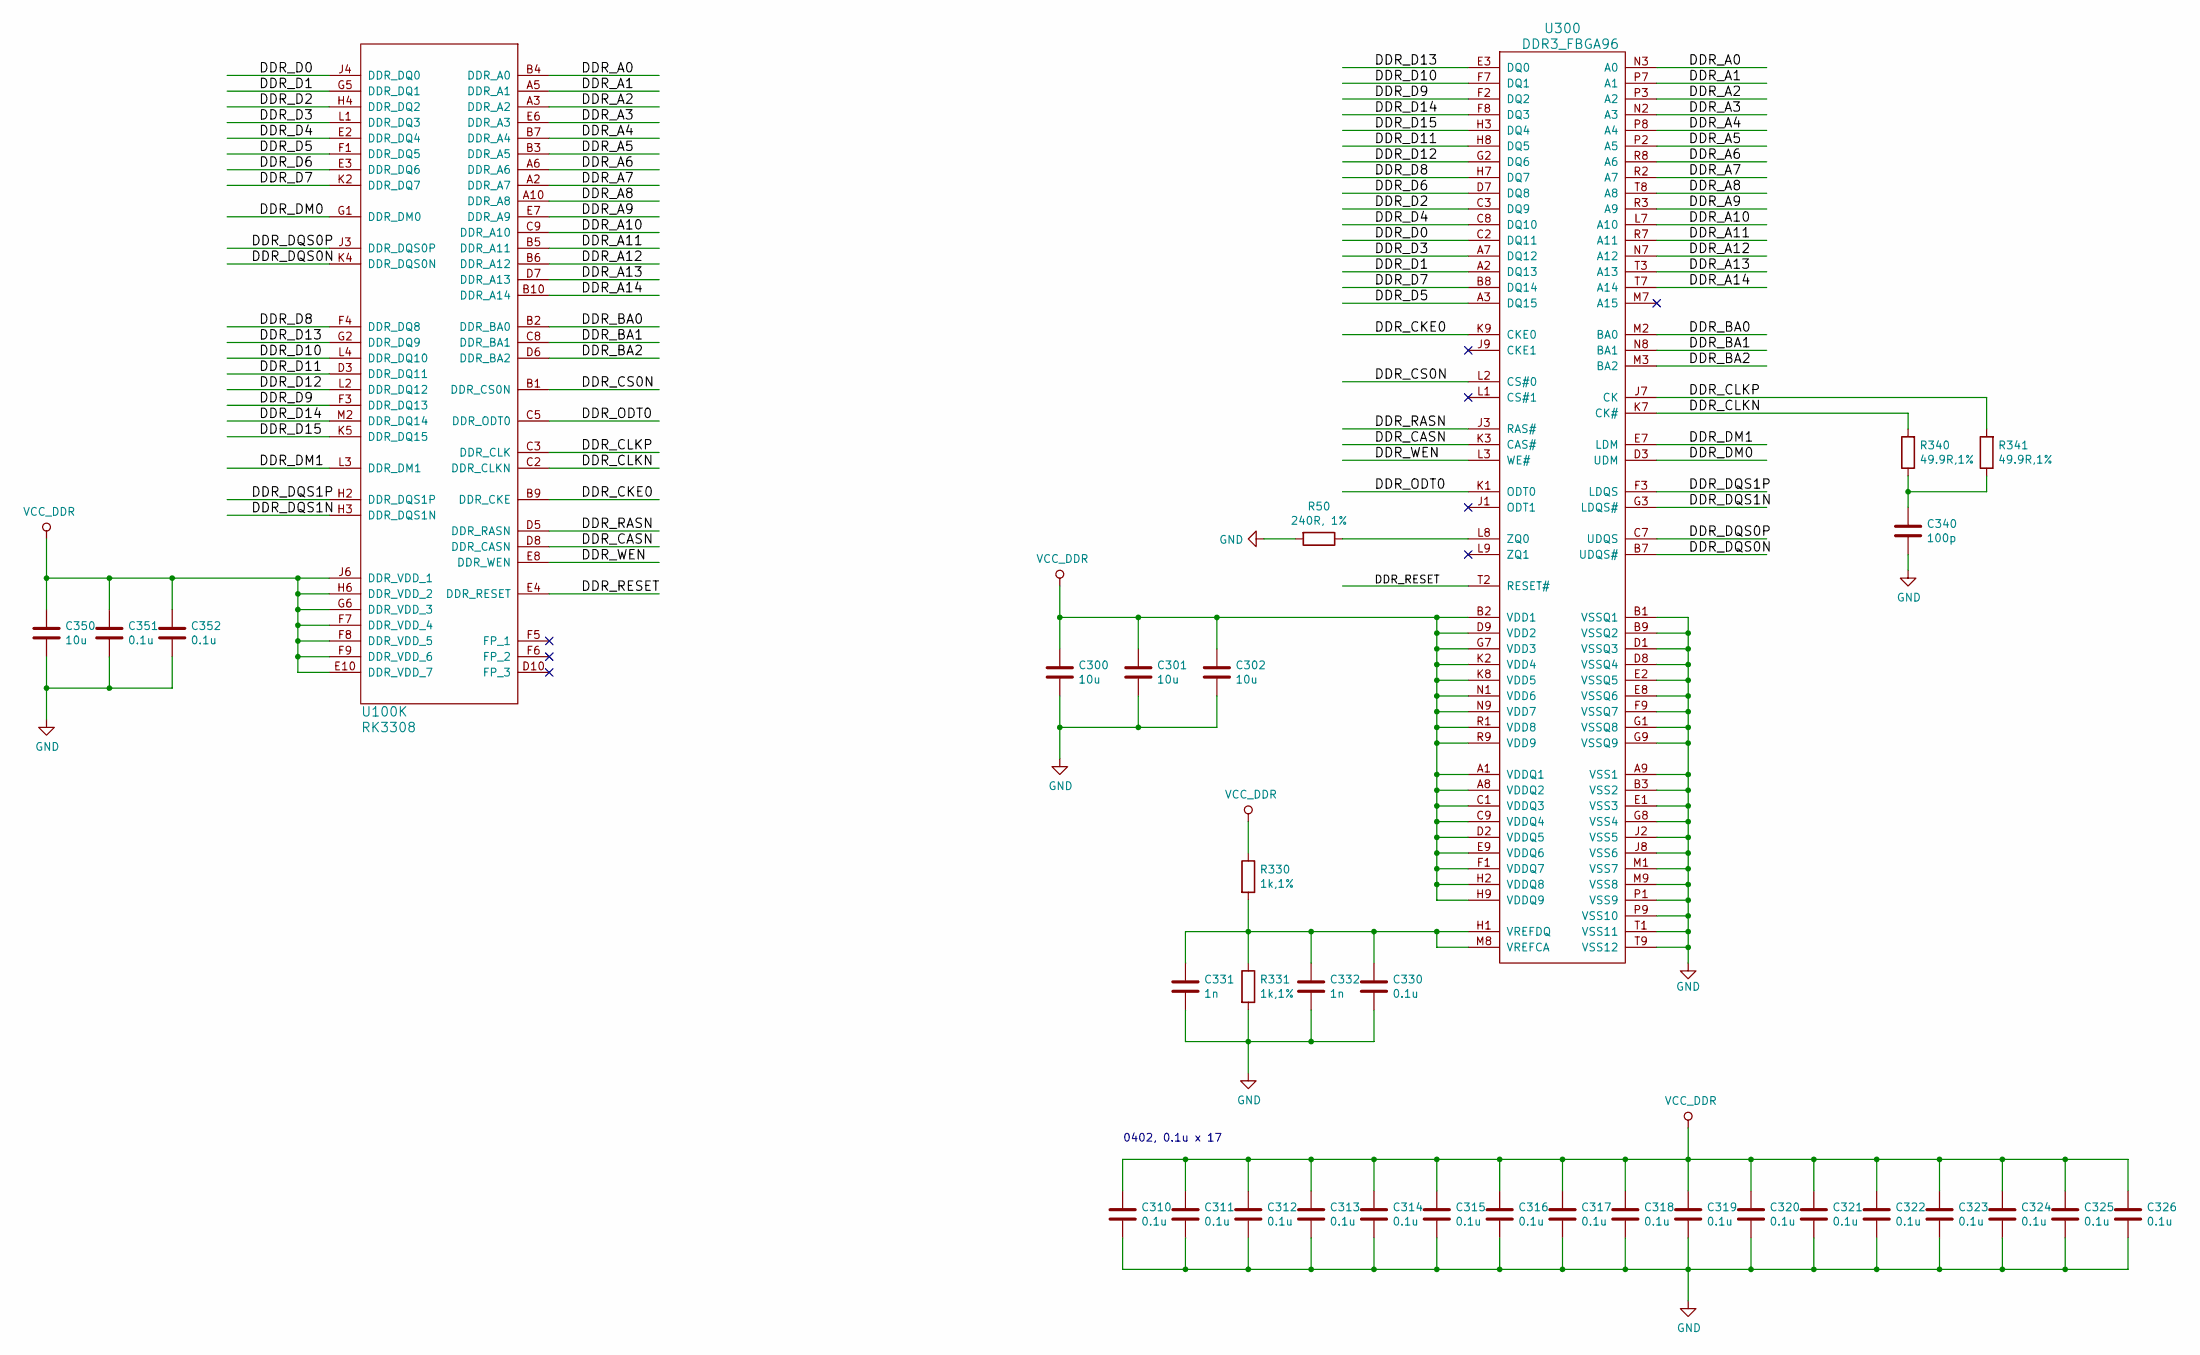
[picture p27: schematic ddr.sch]

Parts:
C300, C301, C302, C350: 10u; C_0603
C310, C311, C312, C313, C314, C315, C316, C317, C318, C319, C320, C321, C322, C323, C324, C325, C326, C330, C351, C352: 0.1u; C_0402
C331, C332: 1n; C_0402
C340: 100p; C_0402
R50: 240R, 1%; R_0402
R330, R331: 1k,1%; R_0402
R340, R341: 49.9R,1%; R_0402
U100: RK3308; RK3308_TFBGA-355
U300: DDR3_FBGA96; DDR3_BGA-96

Connections:
/ddr/DDR_A0: U100.B4 (DDR_A0), U300.N3 (A0)
/ddr/DDR_A1: U100.A5 (DDR_A1), U300.P7 (A1)
/ddr/DDR_A2: U100.A3 (DDR_A2), U300.P3 (A2)
/ddr/DDR_A3: U100.E6 (DDR_A3), U300.N2 (A3)
/ddr/DDR_A4: U100.B7 (DDR_A4), U300.P8 (A4)
/ddr/DDR_A5: U100.B3 (DDR_A5), U300.P2 (A5)
/ddr/DDR_A6: U100.A6 (DDR_A6), U300.R8 (A6)
/ddr/DDR_A7: U100.A2 (DDR_A7), U300.R2 (A7)
/ddr/DDR_A8: U100.A10 (DDR_A8), U300.T8 (A8)
/ddr/DDR_A9: U100.E7 (DDR_A9), U300.R3 (A9)
/ddr/DDR_A10: U100.C9 (DDR_A10), U300.L7 (A10)
/ddr/DDR_A11: U100.B5 (DDR_A11), U300.R7 (A11)
/ddr/DDR_A12: U100.B6 (DDR_A12), U300.N7 (A12)
/ddr/DDR_A13: U100.D7 (DDR_A13), U300.T3 (A13)
/ddr/DDR_A14: U100.B10 (DDR_A14), U300.T7 (A14)
/ddr/DDR_BA0: U100.B2 (DDR_BA0), U300.M2 (BA0)
/ddr/DDR_BA1: U100.C8 (DDR_BA1), U300.N8 (BA1)
/ddr/DDR_BA2: U100.D6 (DDR_BA2), U300.M3 (BA2)
/ddr/DDR_CASN: U100.D8 (DDR_CASN), U300.K3 (CAS#)
/ddr/DDR_CKE0: U100.B9 (DDR_CKE), U300.K9 (CKE0)
/ddr/DDR_CLKN: R340.2, U100.C2 (DDR_CLKN), U300.K7 (CK#)
/ddr/DDR_CLKP: R341.2, U100.C3 (DDR_CLK), U300.J7 (CK)
/ddr/DDR_CS0N: U100.B1 (DDR_CS0N), U300.L2 (CS#0)
/ddr/DDR_D0: U100.J4 (DDR_DQ0), U300.C2 (DQ11)
/ddr/DDR_D1: U100.G5 (DDR_DQ1), U300.A2 (DQ13)
/ddr/DDR_D2: U100.H4 (DDR_DQ2), U300.C3 (DQ9)
/ddr/DDR_D3: U100.L1 (DDR_DQ3), U300.A7 (DQ12)
/ddr/DDR_D4: U100.E2 (DDR_DQ4), U300.C8 (DQ10)
/ddr/DDR_D5: U100.F1 (DDR_DQ5), U300.A3 (DQ15)
/ddr/DDR_D6: U100.E3 (DDR_DQ6), U300.D7 (DQ8)
/ddr/DDR_D7: U100.K2 (DDR_DQ7), U300.B8 (DQ14)
/ddr/DDR_D8: U100.F4 (DDR_DQ8), U300.H7 (DQ7)
/ddr/DDR_D9: U100.F3 (DDR_DQ13), U300.F2 (DQ2)
/ddr/DDR_D10: U100.L4 (DDR_DQ10), U300.F7 (DQ1)
/ddr/DDR_D11: U100.D3 (DDR_DQ11), U300.H8 (DQ5)
/ddr/DDR_D12: U100.L2 (DDR_DQ12), U300.G2 (DQ6)
/ddr/DDR_D13: U100.G2 (DDR_DQ9), U300.E3 (DQ0)
/ddr/DDR_D14: U100.M2 (DDR_DQ14), U300.F8 (DQ3)
/ddr/DDR_D15: U100.K5 (DDR_DQ15), U300.H3 (DQ4)
/ddr/DDR_DM0: U100.G1 (DDR_DM0), U300.D3 (UDM)
/ddr/DDR_DM1: U100.L3 (DDR_DM1), U300.E7 (LDM)
/ddr/DDR_DQS0N: U100.K4 (DDR_DQS0N), U300.B7 (UDQS#)
/ddr/DDR_DQS0P: U100.J3 (DDR_DQS0P), U300.C7 (UDQS)
/ddr/DDR_DQS1N: U100.H3 (DDR_DQS1N), U300.G3 (LDQS#)
/ddr/DDR_DQS1P: U100.H2 (DDR_DQS1P), U300.F3 (LDQS)
/ddr/DDR_ODT0: U100.C5 (DDR_ODT0), U300.K1 (ODT0)
/ddr/DDR_RASN: U100.D5 (DDR_RASN), U300.J3 (RAS#)
/ddr/DDR_RESET: U100.E4 (DDR_RESET), U300.T2 (RESET#)
/ddr/DDR_WEN: U100.E8 (DDR_WEN), U300.L3 (WE#)
GND: C300.2, C301.2, C302.2, C310.2, C311.2, C312.2, C313.2, C314.2, C315.2, C316.2, C317.2, C318.2, C319.2, C320.2, C321.2, C322.2, C323.2, C324.2, C325.2, C326.2, C330.2, C331.2, C332.2, C340.2, C350.2, C351.2, C352.2, R50.2, R331.2, U300.A9 (VSS1), U300.B1 (VSSQ1), U300.B3 (VSS2), U300.B9 (VSSQ2), U300.D1 (VSSQ3), U300.D8 (VSSQ4), U300.E1 (VSS3), U300.E2 (VSSQ5), U300.E8 (VSSQ6), U300.F9 (VSSQ7), U300.G1 (VSSQ8), U300.G8 (VSS4), U300.G9 (VSSQ9), U300.J2 (VSS5), U300.J8 (VSS6), U300.M1 (VSS7), U300.M9 (VSS8), U300.P1 (VSS9), U300.P9 (VSS10), U300.T1 (VSS11), U300.T9 (VSS12); also elsewhere on the board
unnamed: C330.1, C331.1, C332.1, R330.2, R331.1, U300.H1 (VREFDQ), U300.M8 (VREFCA)
unnamed: C340.1, R340.1, R341.1
unnamed: R50.1, U300.L8 (ZQ0)
VCC_DDR: C300.1, C301.1, C302.1, C310.1, C311.1, C312.1, C313.1, C314.1, C315.1, C316.1, C317.1, C318.1, C319.1, C320.1, C321.1, C322.1, C323.1, C324.1, C325.1, C326.1, C350.1, C351.1, C352.1, R330.1, U100.E10 (DDR_VDD_7), U100.F7 (DDR_VDD_4), U100.F8 (DDR_VDD_5), U100.F9 (DDR_VDD_6), U100.G6 (DDR_VDD_3), U100.H6 (DDR_VDD_2), U100.J6 (DDR_VDD_1), U300.A1 (VDDQ1), U300.A8 (VDDQ2), U300.B2 (VDD1), U300.C1 (VDDQ3), U300.C9 (VDDQ4), U300.D2 (VDDQ5), U300.D9 (VDD2), U300.E9 (VDDQ6), U300.F1 (VDDQ7), U300.G7 (VDD3), U300.H2 (VDDQ8), U300.H9 (VDDQ9), U300.K2 (VDD4), U300.K8 (VDD5), U300.N1 (VDD6), U300.N9 (VDD7), U300.R1 (VDD8), U300.R9 (VDD9); also elsewhere on the board

Notes on the sheet:
0402, 0.1u x 17

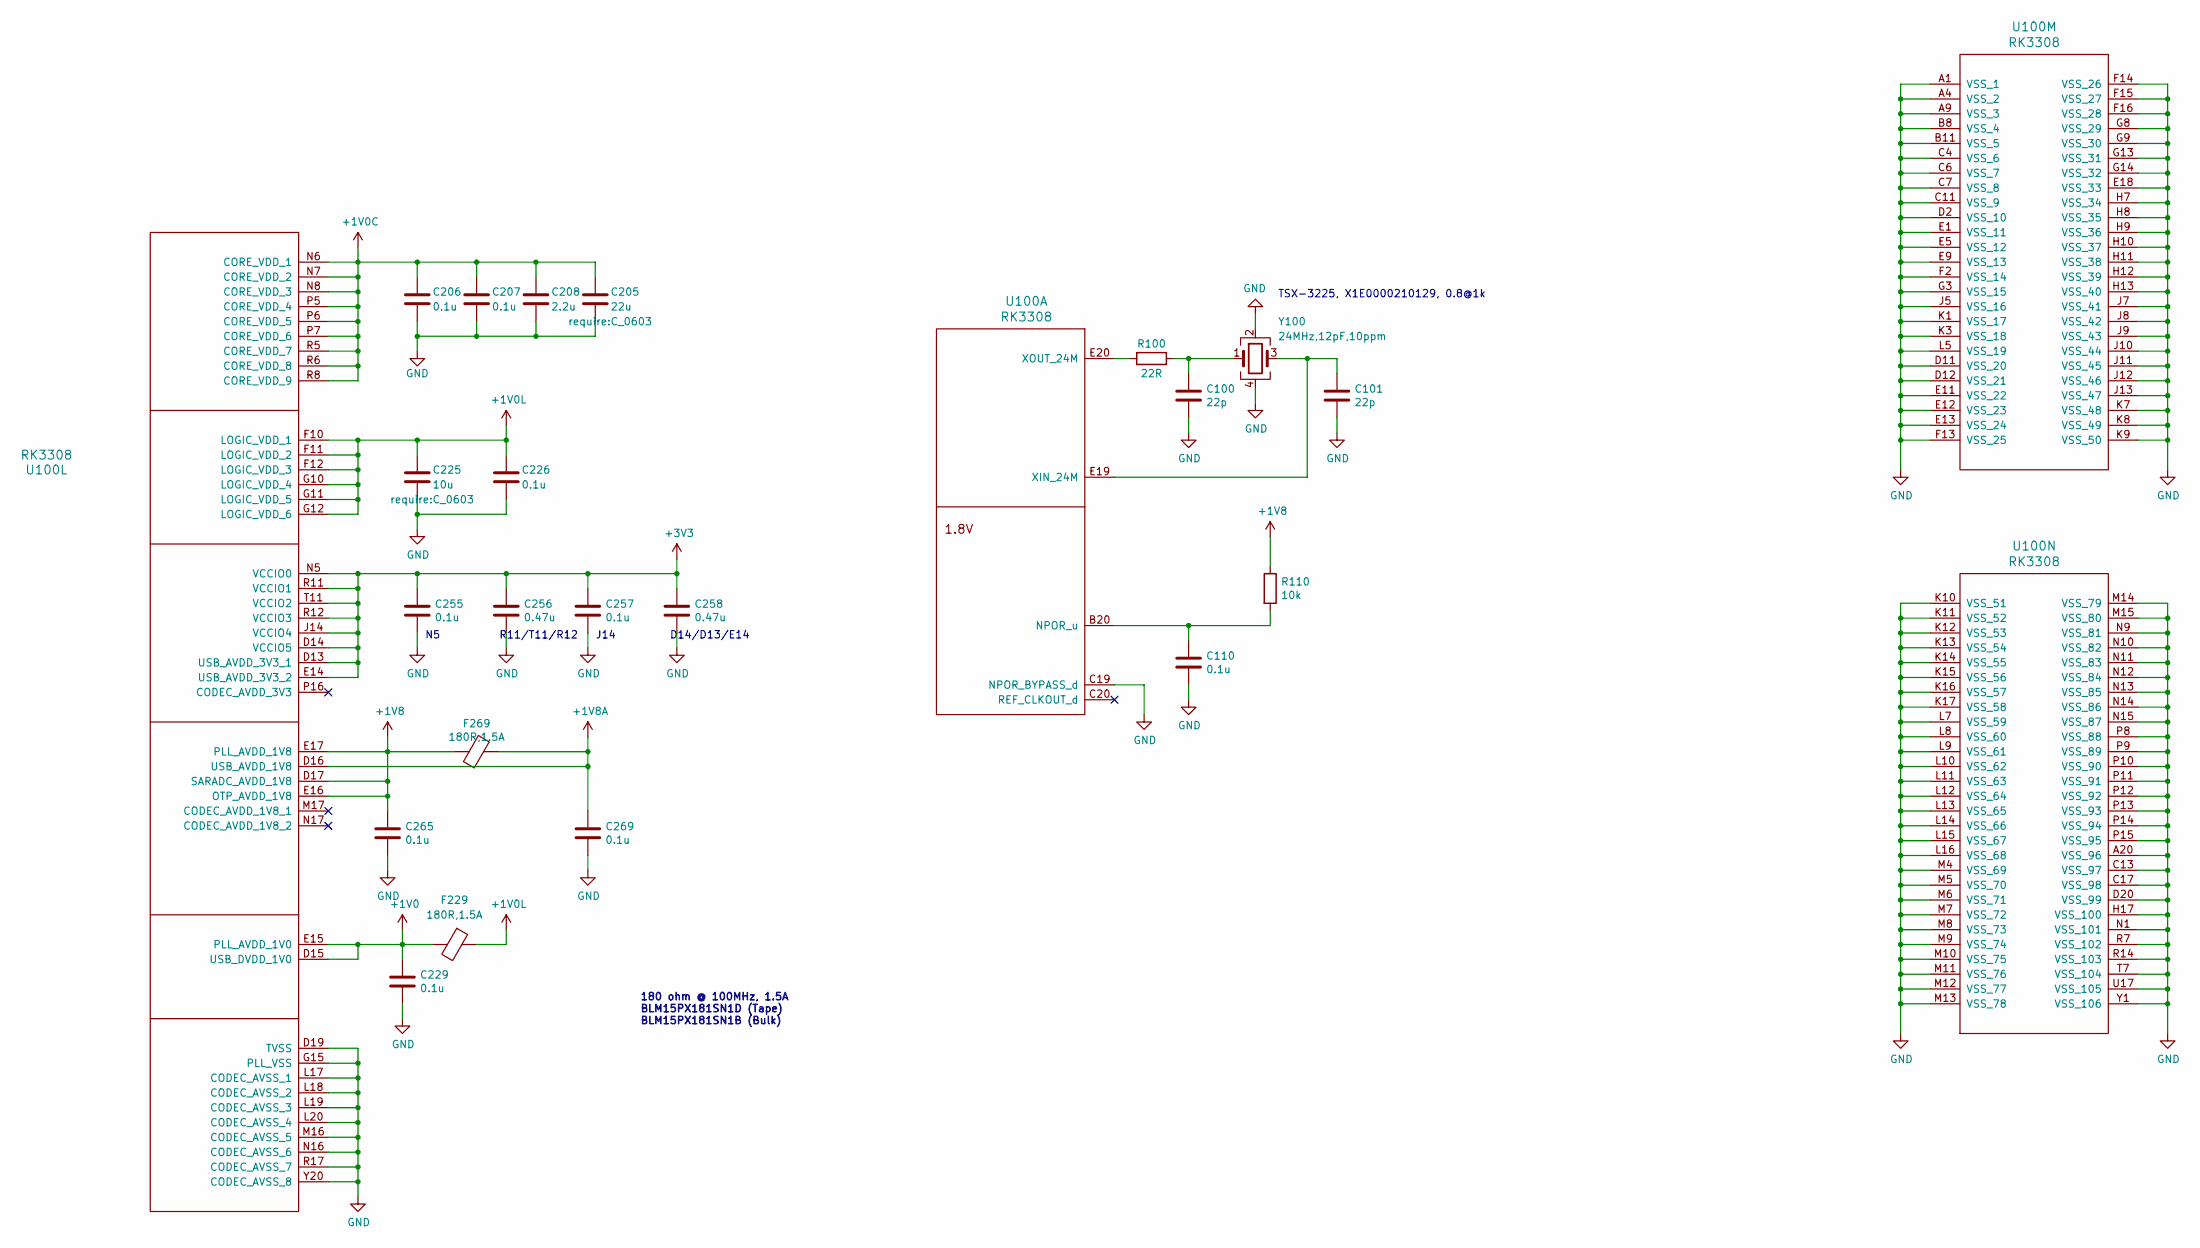
[picture p28: schematic rk3308-power.sch]

Parts:
C100, C101: 22p; C_0402
C110, C206, C207, C226, C229, C255, C257, C265, C269: 0.1u; C_0402
C205: 22u; C_0603
C208: 2.2u; C_0402
C225: 10u; C_0603
C256, C258: 0.47u; C_0402
F229, F269: 180R,1.5A; L_0402
R100: 22R; R_0402
R110: 10k; R_0402
U100: RK3308; RK3308_TFBGA-355
Y100: 24MHz,12pF,10ppm; Crystal_SMD_2016-4pin_2.0x1.6mm

Connections:
+1V0: C229.1, F229.2, U100.D15 (USB_DVDD_1V0), U100.E15 (PLL_AVDD_1V0)
+1V0C: C205.1, C206.1, C207.1, C208.1, U100.N6 (CORE_VDD_1), U100.N7 (CORE_VDD_2), U100.N8 (CORE_VDD_3), U100.P5 (CORE_VDD_4), U100.P6 (CORE_VDD_5), U100.P7 (CORE_VDD_6), U100.R5 (CORE_VDD_7), U100.R6 (CORE_VDD_8), U100.R8 (CORE_VDD_9); also elsewhere on the board
+1V0L: C225.1, C226.1, F229.1, U100.F10 (LOGIC_VDD_1), U100.F11 (LOGIC_VDD_2), U100.F12 (LOGIC_VDD_3), U100.G10 (LOGIC_VDD_4), U100.G11 (LOGIC_VDD_5), U100.G12 (LOGIC_VDD_6); also elsewhere on the board
+1V8: C265.1, F269.1, R110.1, U100.D17 (SARADC_AVDD_1V8), U100.E16 (OTP_AVDD_1V8), U100.E17 (PLL_AVDD_1V8); also elsewhere on the board
+1V8A: C269.1, F269.2, U100.D16 (USB_AVDD_1V8)
+3V3: C255.1, C256.1, C257.1, C258.1, U100.D13 (USB_AVDD_3V3_1), U100.D14 (VCCIO5), U100.E14 (USB_AVDD_3V3_2), U100.J14 (VCCIO4), U100.N5 (VCCIO0), U100.R11 (VCCIO1), U100.R12 (VCCIO3), U100.T11 (VCCIO2); also elsewhere on the board
GND: C100.2, C101.2, C110.2, C205.2, C206.2, C207.2, C208.2, C225.2, C226.2, C229.2, C255.2, C256.2, C257.2, C258.2, C265.2, C269.2, U100.A1 (VSS_1), U100.A4 (VSS_2), U100.A9 (VSS_3), U100.A20 (VSS_96), U100.B8 (VSS_4), U100.B11 (VSS_5), U100.C4 (VSS_6), U100.C6 (VSS_7), U100.C7 (VSS_8), U100.C11 (VSS_9), U100.C13 (VSS_97), U100.C17 (VSS_98), U100.C19 (NPOR_BYPASS_d), U100.D2 (VSS_10), U100.D11 (VSS_20), U100.D12 (VSS_21), U100.D19 (TVSS), U100.D20 (VSS_99), U100.E1 (VSS_11), U100.E5 (VSS_12), U100.E9 (VSS_13), U100.E11 (VSS_22), U100.E12 (VSS_23), U100.E13 (VSS_24), U100.E18 (VSS_33), U100.F2 (VSS_14), U100.F13 (VSS_25), U100.F14 (VSS_26), U100.F15 (VSS_27), U100.F16 (VSS_28), U100.G3 (VSS_15), U100.G8 (VSS_29), U100.G9 (VSS_30), U100.G13 (VSS_31), U100.G14 (VSS_32), U100.G15 (PLL_VSS), U100.H7 (VSS_34), U100.H8 (VSS_35), U100.H9 (VSS_36), U100.H10 (VSS_37), U100.H11 (VSS_38), U100.H12 (VSS_39), U100.H13 (VSS_40), U100.H17 (VSS_100), U100.J5 (VSS_16), U100.J7 (VSS_41), U100.J8 (VSS_42), U100.J9 (VSS_43), U100.J10 (VSS_44), U100.J11 (VSS_45), U100.J12 (VSS_46), U100.J13 (VSS_47), U100.K1 (VSS_17), U100.K3 (VSS_18), U100.K7 (VSS_48), U100.K8 (VSS_49), U100.K9 (VSS_50), U100.K10 (VSS_51), U100.K11 (VSS_52), U100.K12 (VSS_53), U100.K13 (VSS_54), U100.K14 (VSS_55), U100.K15 (VSS_56), U100.K16 (VSS_57), U100.K17 (VSS_58), U100.L5 (VSS_19), U100.L7 (VSS_59), U100.L8 (VSS_60), U100.L9 (VSS_61), U100.L10 (VSS_62), U100.L11 (VSS_63), U100.L12 (VSS_64), U100.L13 (VSS_65), U100.L14 (VSS_66), U100.L15 (VSS_67), U100.L16 (VSS_68), U100.L17 (CODEC_AVSS_1), U100.L18 (CODEC_AVSS_2), U100.L19 (CODEC_AVSS_3), U100.L20 (CODEC_AVSS_4), U100.M4 (VSS_69), U100.M5 (VSS_70), U100.M6 (VSS_71), U100.M7 (VSS_72), U100.M8 (VSS_73), U100.M9 (VSS_74), U100.M10 (VSS_75), U100.M11 (VSS_76), U100.M12 (VSS_77), U100.M13 (VSS_78), U100.M14 (VSS_79), U100.M15 (VSS_80), U100.M16 (CODEC_AVSS_5), U100.N1 (VSS_101), U100.N9 (VSS_81), U100.N10 (VSS_82), U100.N11 (VSS_83), U100.N12 (VSS_84), U100.N13 (VSS_85), U100.N14 (VSS_86), U100.N15 (VSS_87), U100.N16 (CODEC_AVSS_6), U100.P8 (VSS_88), U100.P9 (VSS_89), U100.P10 (VSS_90), U100.P11 (VSS_91), U100.P12 (VSS_92), U100.P13 (VSS_93), U100.P14 (VSS_94), U100.P15 (VSS_95), U100.R7 (VSS_102), U100.R14 (VSS_103), U100.R17 (CODEC_AVSS_7), U100.T7 (VSS_104), U100.U17 (VSS_105), U100.Y1 (VSS_106), U100.Y20 (CODEC_AVSS_8), Y100.2, Y100.4; also elsewhere on the board
unnamed: C100.1, R100.1, Y100.1
unnamed: C101.1, U100.E19 (XIN_24M), Y100.3
unnamed: C110.1, R110.2, U100.B20 (NPOR_u)
unnamed: R100.2, U100.E20 (XOUT_24M)

Notes on the sheet:
180 ohm @ 100MHz, 1.5A BLM15PX181SN1D (Tape) BLM15PX181SN1B (Bulk)
R11/T11/R12
J14
D14/D13/E14
TSX-3225, X1E0000210129, 0.8@1k

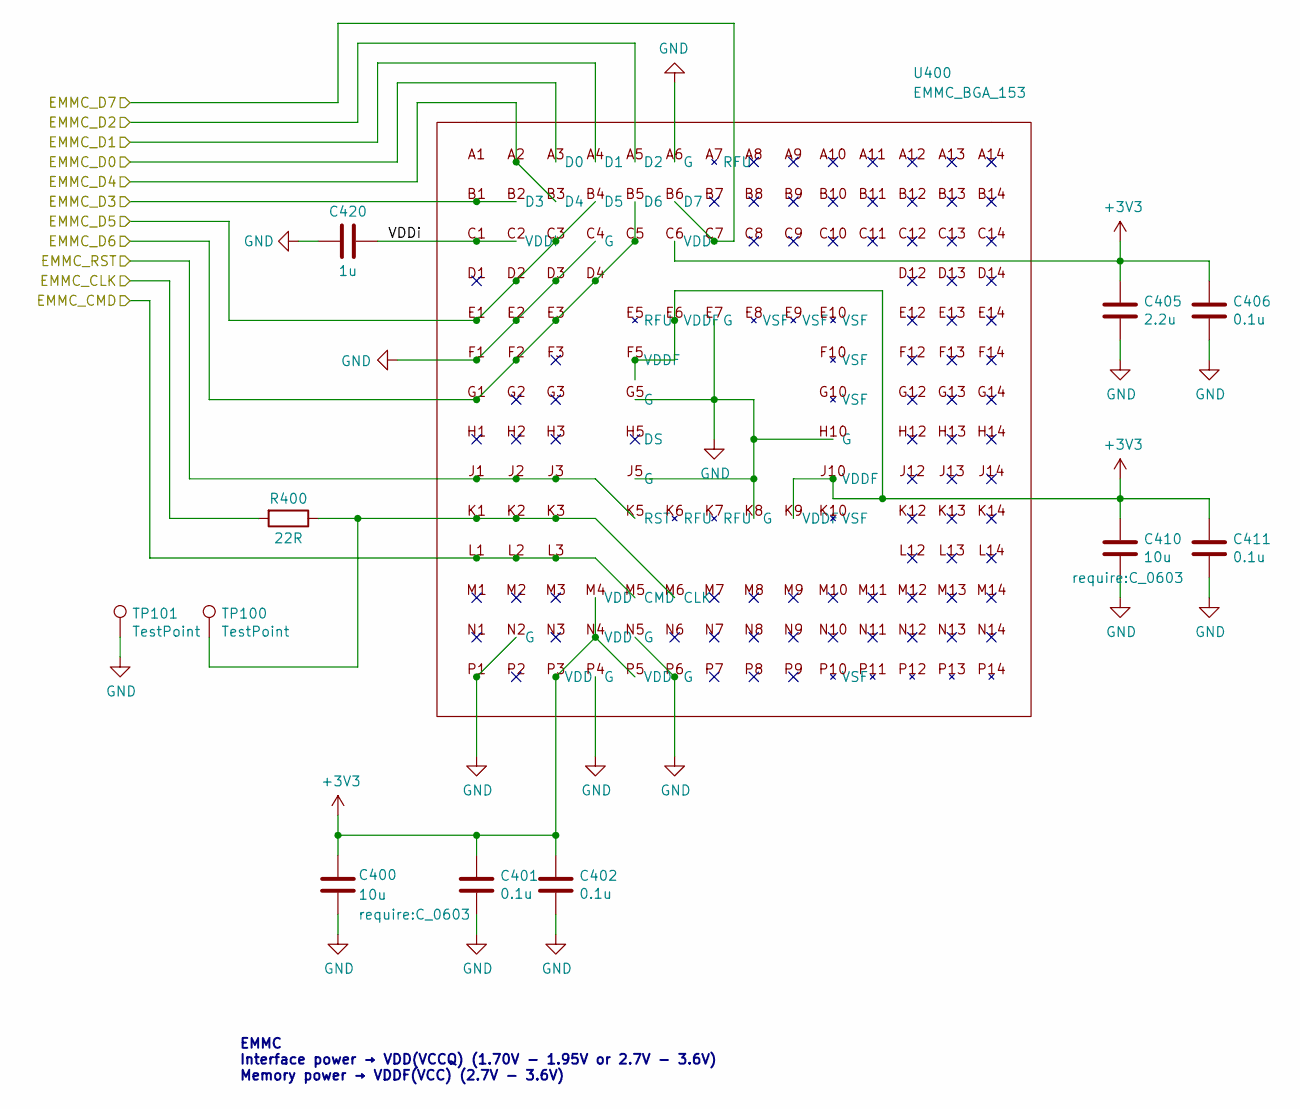
[picture p29: schematic emmc.sch]

Parts:
C400, C410: 10u; C_0603
C401, C402, C406, C411: 0.1u; C_0402
C405: 2.2u; C_0402
C420: 1u; C_0402
R400: 22R; R_0402
TP100, TP101: TestPoint; TP08
U400: EMMC_BGA_153; BGA-153_14x14_11.5x13.0mm

Connections:
+3V3: C400.1, C401.1, C402.1, C405.1, C406.1, C410.1, C411.1, U400.C6 (VDD), U400.E6 (VDDF), U400.F5 (VDDF), U400.J10 (VDDF), U400.K9 (VDDF), U400.M4 (VDD), U400.N4 (VDD), U400.P3 (VDD), U400.P5 (VDD); also elsewhere on the board
/emmc/EMMC_CLK: R400.2; also elsewhere on the board
/emmc/EMMC_CMD: U400.L1, U400.L2, U400.L3, U400.M5 (CMD); also elsewhere on the board
/emmc/EMMC_D0: U400.A3 (D0); also elsewhere on the board
/emmc/EMMC_D1: U400.A4 (D1); also elsewhere on the board
/emmc/EMMC_D2: U400.A5 (D2); also elsewhere on the board
/emmc/EMMC_D3: U400.B1, U400.B2 (D3); also elsewhere on the board
/emmc/EMMC_D4: U400.A2, U400.B3 (D4); also elsewhere on the board
/emmc/EMMC_D5: U400.B4 (D5), U400.C3, U400.D2, U400.E1; also elsewhere on the board
/emmc/EMMC_D6: U400.B5 (D6), U400.C5, U400.D4, U400.E3, U400.F2, U400.G1; also elsewhere on the board
/emmc/EMMC_D7: U400.B6 (D7), U400.C7; also elsewhere on the board
/emmc/EMMC_RST: U400.J1, U400.J2, U400.J3, U400.K5 (RST); also elsewhere on the board
/emmc/VDDi: C420.1, U400.C1, U400.C2 (VDDI)
GND: C400.2, C401.2, C402.2, C405.2, C406.2, C410.2, C411.2, C420.2, TP101.1, U400.A6 (G), U400.C4 (G), U400.D3, U400.E2, U400.E7 (G), U400.F1, U400.G5 (G), U400.H10 (G), U400.J5 (G), U400.K8 (G), U400.N2 (G), U400.N5 (G), U400.P1, U400.P4 (G), U400.P6 (G); also elsewhere on the board
unnamed: R400.1, TP100.1, U400.K1, U400.K2, U400.K3, U400.M6 (CLK)

Notes on the sheet:
EMMC Interface power → VDD(VCCQ) (1.70V - 1.95V or 2.7V - 3.6V) Memory power → VDDF(VCC) (2.7V - 3.6V)
