facethesouth/require/hardware/require.kicad_pcb

## KiCad design hardware/require.kicad_pcb (continued)

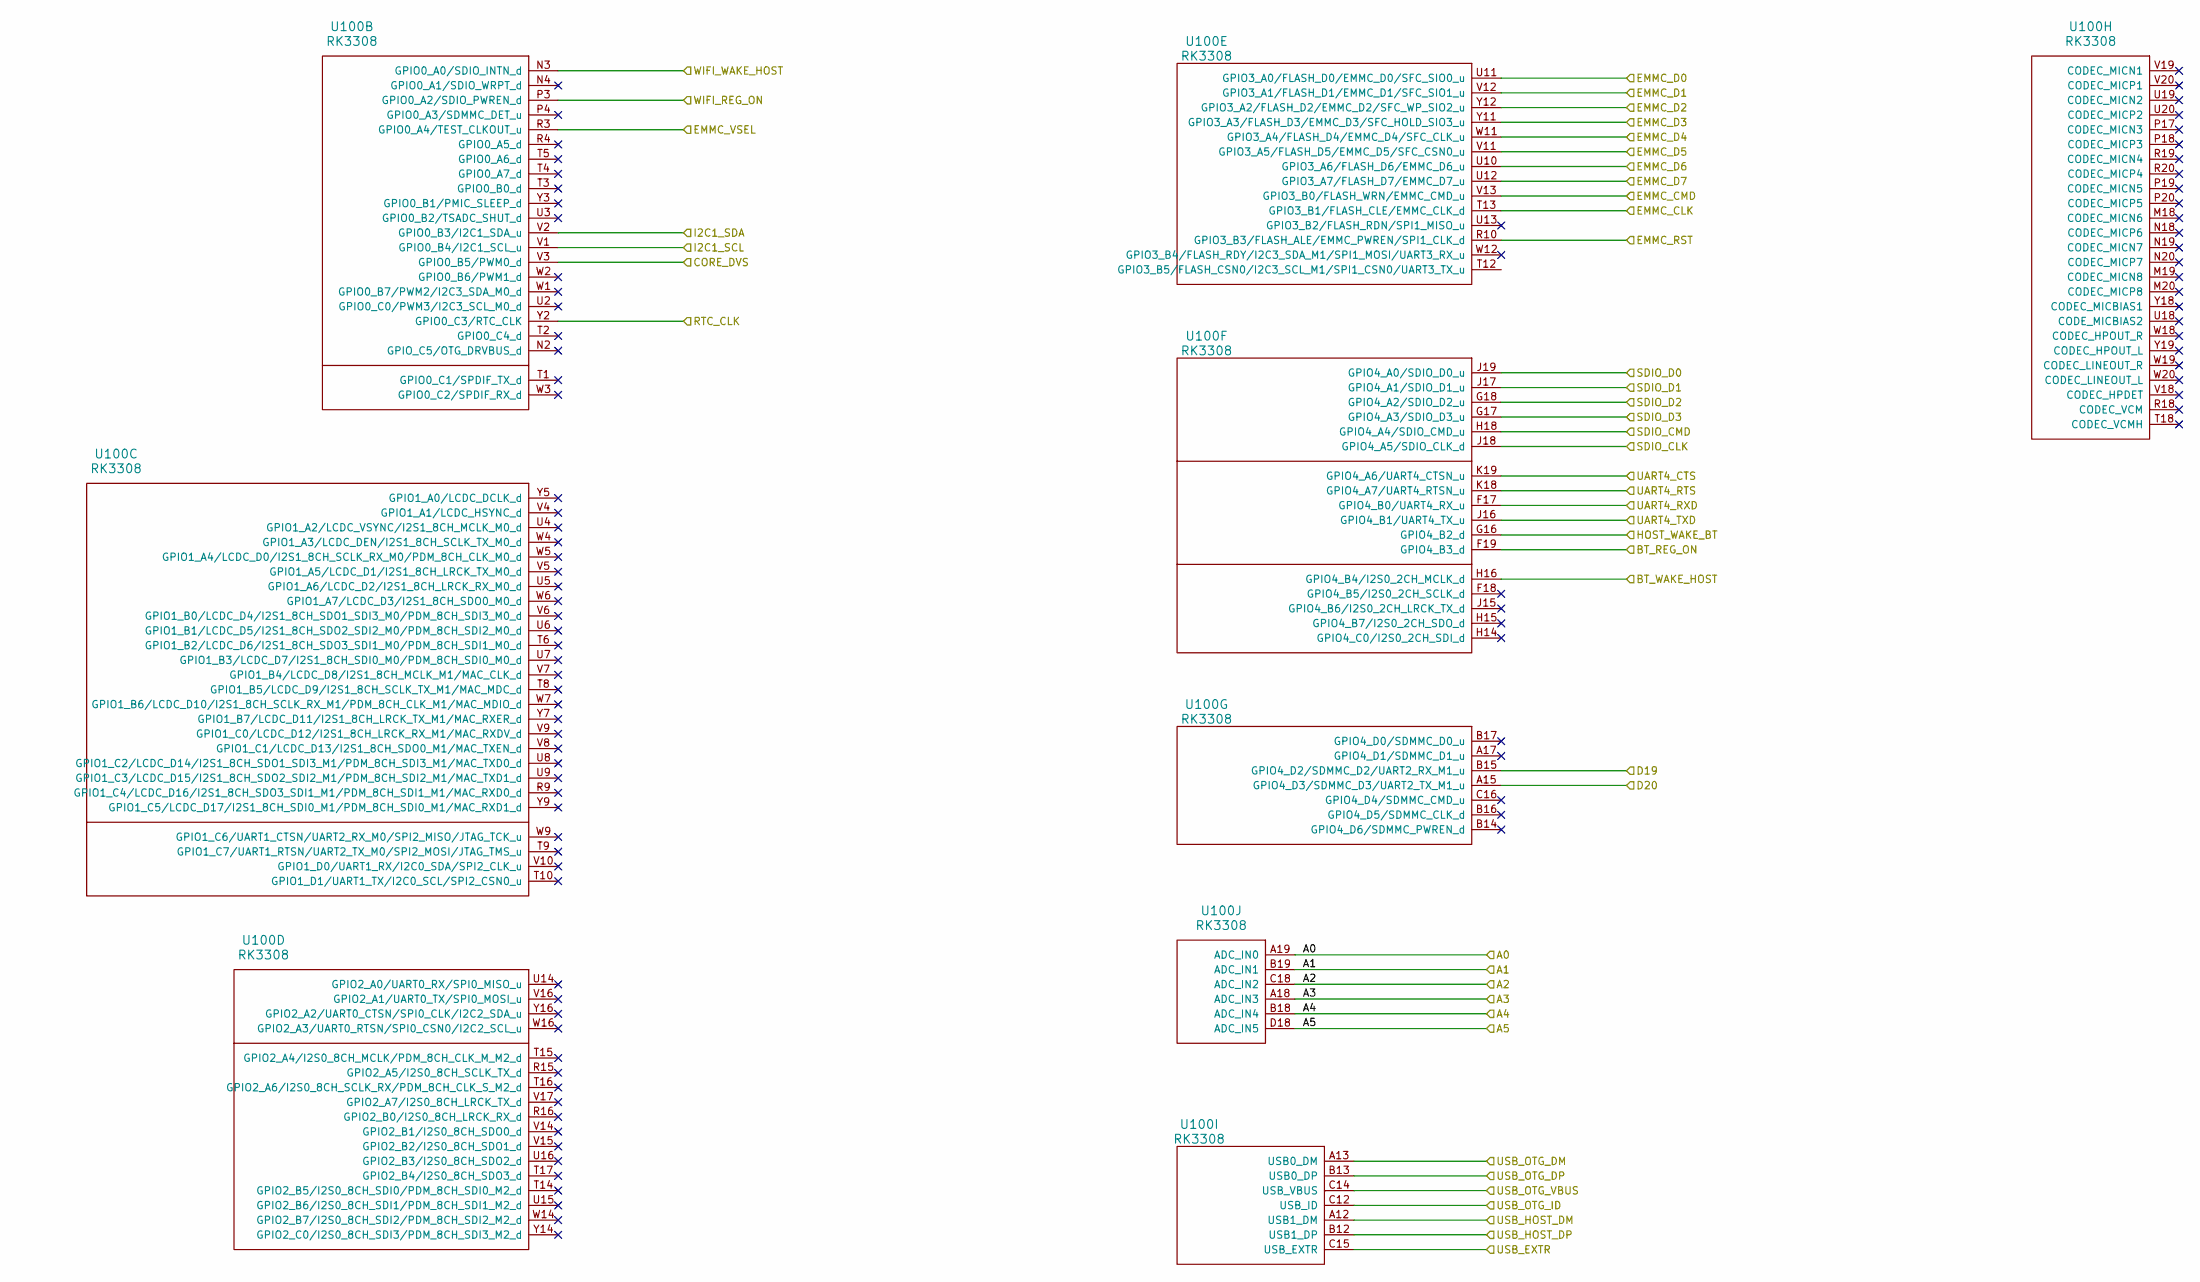
[picture p30: schematic rk3308-io.sch]

Parts:
U100: RK3308; RK3308_TFBGA-355

Connections:
+3V3: U100.C14 (USB_VBUS); also elsewhere on the board
/USB_OTG_D_N: U100.A13 (USB0_DM); also elsewhere on the board
/USB_OTG_D_P: U100.B13 (USB0_DP); also elsewhere on the board
/emmc/EMMC_CLK: U100.T13 (GPIO3_B1/FLASH_CLE/EMMC_CLK_d); also elsewhere on the board
/emmc/EMMC_CMD: U100.V13 (GPIO3_B0/FLASH_WRN/EMMC_CMD_u); also elsewhere on the board
/emmc/EMMC_D0: U100.U11 (GPIO3_A0/FLASH_D0/EMMC_D0/SFC_SIO0_u); also elsewhere on the board
/emmc/EMMC_D1: U100.V12 (GPIO3_A1/FLASH_D1/EMMC_D1/SFC_SIO1_u); also elsewhere on the board
/emmc/EMMC_D2: U100.Y12 (GPIO3_A2/FLASH_D2/EMMC_D2/SFC_WP_SIO2_u); also elsewhere on the board
/emmc/EMMC_D3: U100.Y11 (GPIO3_A3/FLASH_D3/EMMC_D3/SFC_HOLD_SIO3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); also elsewhere on the board
/emmc/EMMC_D4: U100.W11 (GPIO3_A4/FLASH_D4/EMMC_D4/SFC_CLK_u); also elsewhere on the board
/emmc/EMMC_D5: U100.V11 (GPIO3_A5/FLASH_D5/EMMC_D5/SFC_CSN0_u); also elsewhere on the board
/emmc/EMMC_D6: U100.U10 (GPIO3_A6/FLASH_D6/EMMC_D6_u); also elsewhere on the board
/emmc/EMMC_D7: U100.U12 (GPIO3_A7/FLASH_D7/EMMC_D7_u); also elsewhere on the board
/emmc/EMMC_RST: U100.R10 (GPIO3_B3/FLASH_ALE/EMMC_PWREN/SPI1_CLK_d); also elsewhere on the board
/power/CORE_DVS: U100.V3 (GPIO0_B5/PWM0_d); also elsewhere on the board
/rk3308-io/A0: U100.A19 (ADC_IN0)
/rk3308-io/A1: U100.B19 (ADC_IN1)
/rk3308-io/A2: U100.C18 (ADC_IN2)
/rk3308-io/A3: U100.A18 (ADC_IN3)
/rk3308-io/A4: U100.B18 (ADC_IN4); also elsewhere on the board
/rk3308-io/A5: U100.D18 (ADC_IN5)
/rk3308-io/BT_REG_ON: U100.F19 (GPIO4_B3_d); also elsewhere on the board
/rk3308-io/BT_WAKE_HOST: U100.H16 (GPIO4_B4/I2S0_2CH_MCLK_d); also elsewhere on the board
/rk3308-io/D19: U100.B15 (GPIO4_D2/SDMMC_D2/UART2_RX_M1_u); also elsewhere on the board
/rk3308-io/D20: U100.A15 (GPIO4_D3/SDMMC_D3/UART2_TX_M1_u); also elsewhere on the board
/rk3308-io/EMMC_VSEL: U100.R3 (GPIO0_A4/TEST_CLKOUT_u); also elsewhere on the board
/rk3308-io/HOST_WAKE_BT: U100.G16 (GPIO4_B2_d); also elsewhere on the board
/rk3308-io/I2C1_SCL: U100.V1 (GPIO0_B4/I2C1_SCL_u); also elsewhere on the board
/rk3308-io/I2C1_SDA: U100.V2 (GPIO0_B3/I2C1_SDA_u); also elsewhere on the board
/rk3308-io/SDIO_CLK: U100.J18 (GPIO4_A5/SDIO_CLK_d); also elsewhere on the board
/rk3308-io/SDIO_CMD: U100.H18 (GPIO4_A4/SDIO_CMD_u); also elsewhere on the board
/rk3308-io/SDIO_D0: U100.J19 (GPIO4_A0/SDIO_D0_u); also elsewhere on the board
/rk3308-io/SDIO_D1: U100.J17 (GPIO4_A1/SDIO_D1_u); also elsewhere on the board
/rk3308-io/SDIO_D2: U100.G18 (GPIO4_A2/SDIO_D2_u); also elsewhere on the board
/rk3308-io/SDIO_D3: U100.G17 (GPIO4_A3/SDIO_D3_u); also elsewhere on the board
/rk3308-io/UART4_CTS: U100.K19 (GPIO4_A6/UART4_CTSN_u); also elsewhere on the board
/rk3308-io/UART4_RTS: U100.K18 (GPIO4_A7/UART4_RTSN_u); also elsewhere on the board
/rk3308-io/UART4_RXD: U100.F17 (GPIO4_B0/UART4_RX_u); also elsewhere on the board
/rk3308-io/UART4_TXD: U100.J16 (GPIO4_B1/UART4_TX_u); also elsewhere on the board
/rk3308-io/USB_EXTR: U100.C15 (USB_EXTR); also elsewhere on the board
/rk3308-io/USB_HOST_DM: U100.A12 (USB1_DM)
/rk3308-io/USB_HOST_DP: U100.B12 (USB1_DP)
/rk3308-io/USB_OTG_ID: U100.C12 (USB_ID)
/rk3308-io/WIFI_REG_ON: U100.P3 (GPIO0_A2/SDIO_PWREN_d); also elsewhere on the board
/rk3308-io/WIFI_WAKE_HOST: U100.N3 (GPIO0_A0/SDIO_INTN_d); also elsewhere on the board
/wireless/LPO: U100.Y2 (GPIO0_C3/RTC_CLK); also elsewhere on the board

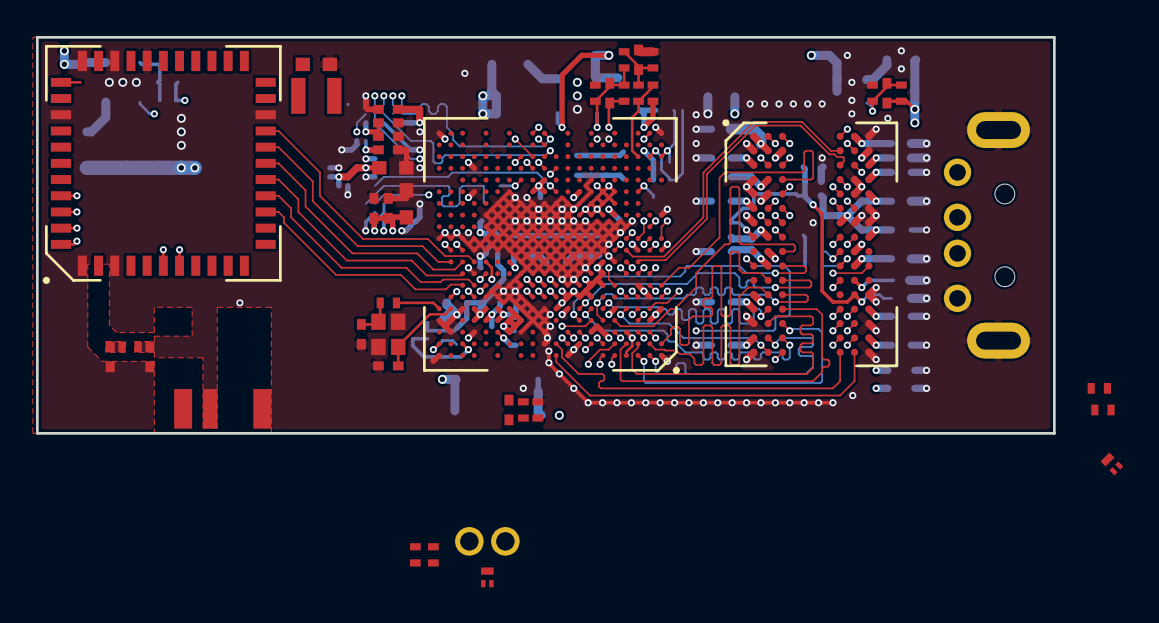
[picture p31: board require.kicad_pcb from above]

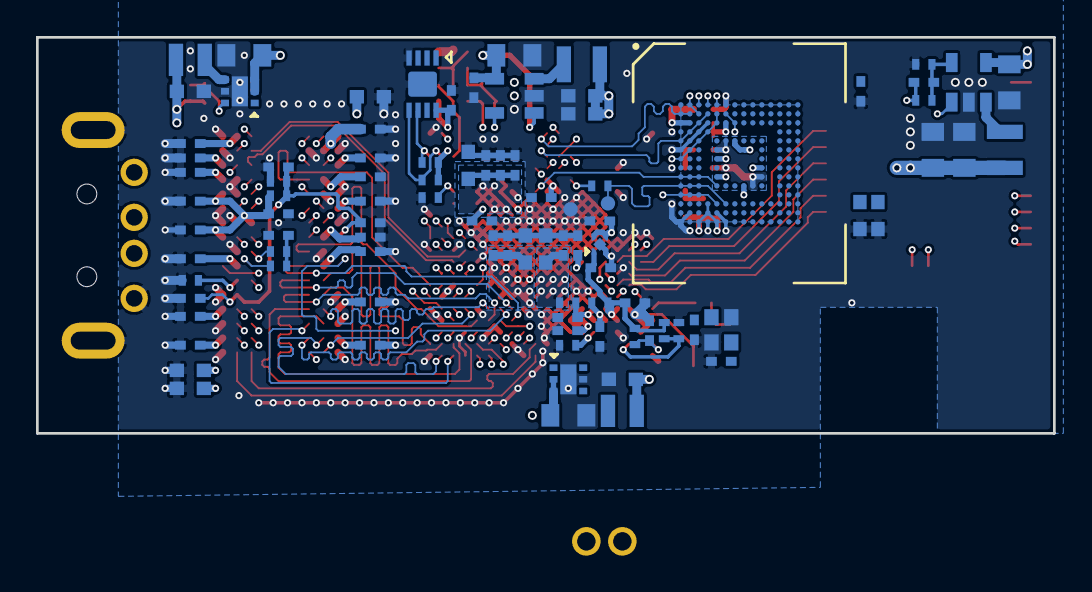
[picture p32: board require.kicad_pcb from below]

Board: 6 copper layers, 56.5 x 22.0 mm, 136 parts (93 on the bottom side), 122 nets.
